ericjhoh/5-DOF-Arm/blog_documentation.docx

# Blog Documentation

## 8/20/2026

Due to all the backlash from the first version of the 30:1 Cycloidal Gearbox, I decided that there were likely 2 things to change that could reduce the given backlash.

1. 3D-print the cycloidal disks slightly larger than before.
2. Reprint the input wall so that the holes holding the roller pins were press-fit instead of loose fit.

I believed that the loose fit of the previous input wall roller pin holes allowed the pins to move slightly when the cycloidal disk applied pressure to the bearings. This means that when switching directions the cycloidal disk would have some give before the disk and the rollers latch back together.

## 8/21/2026

This day was spent printing most of the parts and testing whether they would fit. I found that printing the disk with an offset of .1 mm to increase the size worked the best with my 3d printer. The input wall holes for the roller should be the nominal 5 mm diameter.

## 8/22/2026

After assembly, I observed much less backlash than before and I will be testing the efficiency of the gearbox and compare it to version 1 of the 30:1 cycloidal gearbox. I will also be printing the 15:1 gearbox in the following days after adding identifiers in the CAD to make assembly easier.

## 8/23/2026

I spent this day printing most of the parts. I ran into some issues with the fitting of the shoulder bolts that secure the outer walls of the print, it was very tight for the 15:1.

## 8/24/2026

After assembling the entirety of the 15:1 gearbox, I noticed that the input shaft felt difficult to turn as if it were experiencing a lot of friction. From my observations it seemed like one of the input camshaft part was rubbing against the output flange making more friction.

## 8/25/2026

I didn’t get to work that much on the project this day, but I disassembled the 15:1

## 8/26/2026

After making some edits to the CAD, I am reprinting many parts so that they fit better together.

## 9/2/2026

I assembled the 15:1 gearbox and I loosened some of the shoulder bolts because if it was too tight the input hex shaft would be difficult to move.

## Updates

Tested all the custom cycloidal gearboxes

Bare motor - .2 NM input gave 3.0 N at .075 m away

15:1 - .2 Nm input gave 33.5 at .1 m away

15:1 - .1 NM input gave 15.5 N at .1 m away

30:1 - .1 Nm input gave 28.7 N at .1 m away

Cut hexshaft using a Dremel

May need to re-design the J1-J2 connector because it interferes with some of the interface of the J1 gearbox

Started full assembly of 5-DOF arm

Printed all parts. I had trouble printing the carbon fiber coupler because of the vertical hole where the M2.5 heated insert would be placed. The vertical hole had a very oblong shape. I tweaked the 3D-printer parameters and made the hole smaller in the CAD to allow for a more circular profile. Cut the carbon fiber tubes to length.

Making custom Y-splitter cables with solder in order to daisy chain power between the moteus r4.11 and the c1 controllers.

Extend the 8:1 gearbox phase wires from 16 AWG to 26 AWG with wire, solder, and heat shrink. Recrimp the encoder wires to the right profile of JST GH connectors for the C1

conf set aux1.spi.mode 1

conf set aux2.pins.0.mode 1

conf set aux2.pins.1.mode 1

conf set aux2.pins.2.mode 1

conf set aux2.pins.3.mode 2

conf set aux2.spi.mode 2

conf set aux2.spi.rate_hz 12000000

conf set motor_position.sources.0.aux_number 2

conf set motor_position.sources.0.type 1

conf set motor_position.sources.0.cpr 16384

conf set motor_position.sources.0.reference 0

conf set motor_position.commutation_source 0

conf set motor_position.output.source 0

conf set motor_position.rotor_to_output_ratio 0.125

conf write

## 9/13/26

We spent the entire time debugging CAN BUS communication. Our daisy chained crimped custom wires and solder jst-ph connectors did not seem to work as when we slightly pulled or pushed on the wires the CAN BUS communication did not work

We would run python -m moteus.moteus_tool -s to see if all our motor controllers would be read through the terminal this allowed us to check whether the CAN BUS communication could read all the motors.

After re-soldering the connectors and re-crimping the wires we determined to be faulty, we were able to consistently get the CAN communication fully through the whole arm.

## 9/14/26

We utilized an open source gripper+camera combo and made a custom connector to our J5 actuator. This allows for our robot to see.


9/15/26

Finishing up gripper assembly, and fully assembled robot, getting started on software development. We developed the framework of our robot controller with lerobot.

## 9/16-21/26

We developed the software by first tuning the PID of our motors and then setting joint limits. We first made teleoperation possible using a keyboard then an xbox controller. After practicing the pick-place task using the xbox controller, we recorded 30 observations of the pick-place task. Then using these parameters: ______ and an ACT policy to train the robotic arm, we were able to succeed at the pick-place task 90% of the time with 10 trials.
