ericjhoh/5-DOF-Arm/CAD/GearBoxes/Motor Housing/8_1 gearbox housings/jst-GH-7.png

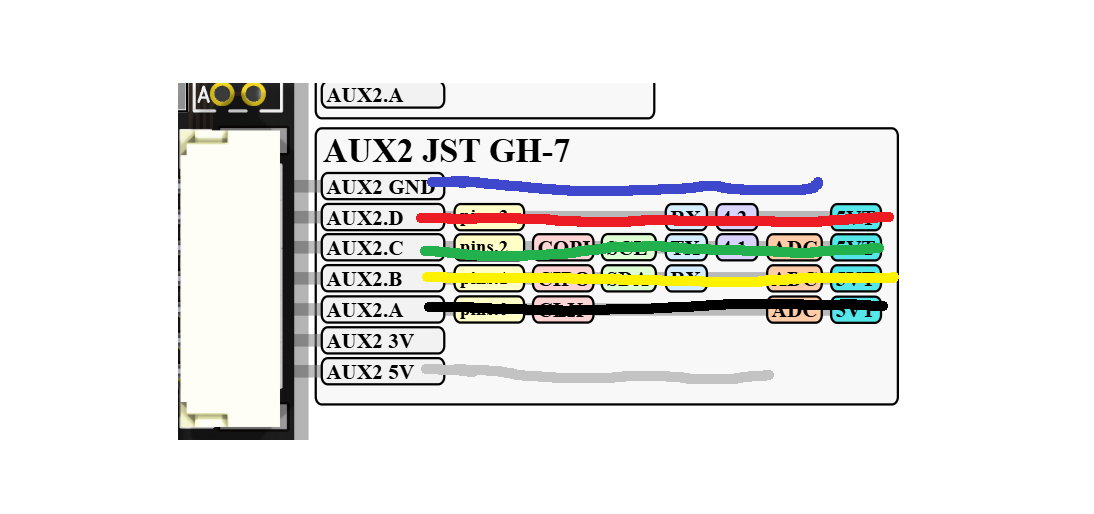
CAD/GearBoxes/Motor Housing/8_1 gearbox housings/jst-GH-7.png
