ericjhoh/5-DOF-Arm/5-DOF-Arm.xlsx

Sheet: Torque Budget
6-DoF Arm — Gravity Torque Budget v2 (elbow-mounted forearm roll)
Joint order (base to tool): J1 yaw·z, J2 shoulder pitch·x, J3 elbow pitch·x, J4 forearm roll·y AT ELBOW, J5 wrist roll·x. Blue cells = inputs. Worst case: arm horizontal.
GEOMETRY (total reach = shoulder pitch axis to tool center point)
L1 — upper arm (shoulder pitch to elbow pitch axis) | 0.250 | m
L2 — forearm (elbow pitch to wrist pitch axis) | 0.025 | m
L3 — wrist pitch axis to TCP | 0.125 | m |  |  |  |  |  | Payload CG assumed at TCP
d4 — J4 roll actuator CG offset distal of elbow | 0.030 | m |  |  |  |  |  | How far past the elbow pitch axis the J4 motor sits
Total reach | 0.400 | m |  |  |  |  |  | Target: 0.400 m as decided
MASSES
J3 elbow pitch actuator (mj5208 + r4.11 + cycloidal) | 0.890 | kg |  |  |  |  |  | Body mounted on upper-arm side of the joint
J4 forearm roll actuator (small motor + driver + housing) | 0.120 | kg |  |  |  |  |  | e.g. gimbal motor ~90 g + moteus-c1 ~9 g + printed reducer/housing
J5 Wrist (small motor + driver + housing) | 0.120 | kg |  |  |  |  |  | Was 0.35 kg with a 3-axis wrist — this is the payoff of the move
Gripper (actuator + jaws) | 0.150 | kg |  |  |  |  |  | Keep under ~0.2 kg
Payload (design requirement) | 0.200 | kg |  |  |  |  |  | 500 g spec
Upper arm link (CF tube + clamps, CG at L1/2) | 0.060 | kg
Forearm link (CF tube + clamps, CG at L1 + L2/2) | 0.060 | kg |  |  |  |  |  | Slightly heavier in practice: it must carry the J4 rotating interface
CONSTANTS & DESIGN FACTORS
Gravitational acceleration g | 9.81 | m/s²
Safety factor on continuous torque | 1.2 |  |  |  |  |  |  | Covers cycloidal friction variation, print quality, dynamic loads while carrying payload
ACTUATOR PARAMETERS
mj5208 continuous torque | 0.30 | Nm |  |  |  |  |  | Your figure, w/ heat spreader @ 24 V. Verify at thermal steady state on the bench.
mj5208 peak torque | 1.70 | Nm |  |  |  |  |  | mjbots spec; transient only
mj5208 speed at continuous rating | 240 | rpm |  |  |  |  |  | No-load speed is much higher; peak joint speed exceeds this
Cycloidal gearbox efficiency | 0.60 | - |  |  |  |  |  | ASSUMPTION — printed cycloidals range ~0.60–0.90. Measure and update.
Gear ratio — J1 base yaw | 15 | :1 |  |  |  |  |  | Gravity load ~0; existing 15:1 design is fine
Gear ratio — J2 shoulder pitch | 30 | :1 |  |  |  |  |  | 15:1 fails the budget below even with the lighter wrist
Gear ratio — J3 elbow pitch | 15 | :1 |  |  |  |  |  | Existing 15:1 design
Small motor continuous torque (J4–J6) | 0.20 | Nm |  |  |  |  |  | e.g. GM4108-class gimbal + moteus-c1. Edit if using a smart servo instead.
Small motor gear ratio (J4–J6) | 8 | :1 |  |  |  |  |  | Printed planetary; J4 wants a hollow bore or belt offset for wiring
Small motor gear efficiency | 0.85 | -
COMPONENT GRAVITY TORQUES — ARM HORIZONTAL (worst case)
Component | Mass (kg) |  | CG dist from shoulder (m) | CG dist from elbow (m) | τ about shoulder (Nm) | τ about elbow (Nm)
Upper arm link | 0.060 |  | 0.125 | — | 0.07 | 0.00
J3 elbow pitch actuator | 0.890 |  | 0.250 | — | 2.18 | 0.00
J4 forearm roll actuator (at elbow) | 0.120 |  | 0.280 | 0.030 | 0.33 | 0.04
Forearm link | 0.060 |  | 0.263 | 0.013 | 0.15 | 0.01
J5 Wrist | 0.120 |  | 0.275 | 0.025 | 0.32 | 0.03
Gripper | 0.150 |  | 0.338 | 0.087 | 0.50 | 0.13
Payload @ TCP | 0.200 |  | 0.400 | 0.150 | 0.78 | 0.29
TOTAL static gravity torque |  |  |  |  | 4.35 | 0.50
DISTAL AXIS GRAVITY TORQUES
Gripper about wrist pitch axis (CG at L3/2) |  |  |  |  | 0.09
Payload about wrist pitch axis (at L3) |  |  |  |  | 0.25
TOTAL — J5 wrist pitch requirement |  |  |  |  | 0.34 |  |  | J4 forearm roll sees the SAME worst case: with the wrist pitched 90°, the gripper + payload hang off the roll axis on the same lever arms
JOINT SIZING SUMMARY
Joint | Required cont. τ (Nm) | Req. × SF (Nm) | Ratio | Available cont. τ (Nm) | Margin (avail / req×SF) | Status | Peak τ avail (Nm) | Output speed (°/s)
J1 base yaw · z (mj5208) | 0.50 | 0.60 | 15 | 2.70 | 4.50 | PASS | 15.3 | 96
J2 shoulder pitch · x (mj5208) | 4.35 | 5.21 | 30 | 5.40 | 1.04 | PASS | 30.6 | 48
J3 elbow pitch · x (mj5208) | 0.50 | 0.59 | 15 | 2.70 | 4.54 | PASS | 15.3 | 96
J4 forearm roll · y (small motor) | 0.34 | 0.40 | 8 | 1.36 | 3.36 | PASS | —
J5 wrist pitch · x (small motor) | 0.34 | 0.40 | 8 | 1.36 | 3.36 | PASS | —
Notes:
• J1 required torque is an input: it carries ~zero gravity torque and is sized by friction + acceleration of full-arm inertia.
• J4 worst case = wrist pitched 90° with payload (same lever arms as J5), so both use the same requirement and actuator for commonality.
• vs the 3-axis-wrist version: shoulder requirement drops ~0.2 Nm and elbow ~0.15 Nm from moving one actuator's mass off the forearm tip.
• Route wiring for J5/gripper through or past J4: limit J4 travel (±~270°) with a cable service loop, or design a hollow-bore reducer.
• After the single-joint bench test, replace the 0.80 cycloidal efficiency assumption with the measured value.

Sheet: Timeline
Build Timeline — 6-DoF Arm for ML/RL Experiments (v2 architecture)
Assumes evenings/weekends pace alongside full-time work. Phases overlap deliberately — order long-lead parts early. Durations are estimates; the exit criterion is what matters.
# | Phase | Weeks | Key tasks & exit criteria | Notes | Recommendations
1 | Finalize budget & architecture | 1–2 | Fill this workbook with real masses; lock reach (400 mm), z-x-x-y-x-y joint layout, J2 ratio, J4–J6 actuator choice. Exit: every joint row reads PASS. | J4 and J5 share a requirement (~0.45 Nm) — use the identical actuator + reducer for both, and ideally J6 too, for spare-parts commonality. | Order long-lead parts NOW: mj5208s, r4.11s, heat spreaders, CAN-FD USB adapter, CF tube, bearings, small motors + moteus-c1s. Shipping is your critical path.
2 | Single-joint bench test (mj5208 + 15:1 cycloidal) | 2–3 | Rig one joint with a weighted lever. Measure: continuous torque at thermal steady state (20+ min hold, log winding temp via moteus telemetry), gearbox efficiency, backlash, friction. Exit: measured values entered into the Torque Budget sheet. | Validates the two biggest assumptions (0.3 Nm continuous, 0.80 efficiency). Printed cycloidal efficiency varies 0.60–0.90 with print quality and grease. | Log via moteus telemetry — the same friction/backlash data becomes your sim parameters later. Compare PETG vs PLA cycloidal discs for wear while you're at it.
3 | J4 roll joint + wrist prototype | 3–5 | Build the J4 forearm roll joint first — it's the novel one: small motor + moteus-c1 + hollow-bore (or belt-offset) reducer, with the distal wiring harness passing through. Then the 2-axis wrist. Exit: J4 holds 0.45 Nm with wiring routed and ±270° travel limits set; wrist cluster weighed at ≤ budget. | The rotating wire pass-through is the highest-risk detail of this architecture. Prove it before committing to the forearm design. Set voltage_mode_control if gimbal current-sense torque is noisy. | Give the harness a generous helical service loop through the J4 bore and enforce soft travel limits in moteus config. If J4 drags on, fall back to a smart-servo wrist and add the roll later.
4 | Full arm CAD | 4–7 | Model complete arm incl. the J4 rotating interface, wiring routes, controller mounting, service loops. Pull mass properties into the Torque Budget sheet and iterate. Exit: budget still PASS with CAD masses + 10% contingency. | Split-clamp CF tube fittings (bolted, not glued) let you change link lengths after testing. Bearings, not printed bores, on all moment-loaded interfaces — especially the J4 output, which sees the full forearm bending moment. | Design so J4, J5, J6 axes intersect at one wrist-center point — that preserves closed-form IK (Pieper's condition). Add joint hard-stops so a runaway policy can't self-collide at full torque.
5 | Electronics & power integration | 6–8 | 24 V PSU (~10–15 A), power distribution, daisy-chained CAN-FD through all 6 controllers + gripper, termination, physical e-stop cutting motor power. Exit: all nodes enumerate; 100 Hz command/telemetry loop stable from Jetson or PC. | One mjcanfd-usb-1x handles the whole chain — r4.11 and c1 share the same bus, firmware, and API. Keep Jetson logic power separate from motor power. | Add a bus voltage monitor: regen from decelerating joints pumps the rail up. Configure moteus flux braking before the first fast motion.
6 | Fabrication & assembly | 7–9 | Print structure (PETG for structural/heat-adjacent parts), cut tubes, assemble, torque-check fasteners. Exit: arm holds a static pose under closed-loop control without thermal throttling. | Expect 2–3 reprints of joint housings; that's normal. Anneal or thicken parts near motor heat spreaders. | Assemble and test joint-by-joint from the base up — much easier to isolate mechanical vs firmware issues.
7 | Calibration & controller tuning | 8–10 | Per-joint encoder calibration, direction/limit config, position + velocity + torque tuning, gravity compensation feedforward from this sheet's mass model. Exit: arm tracks smooth trajectories with 500 g payload, no overheating over a 15-min cycle. | Gravity comp is nearly free — the mass/CG model is already in the Torque Budget sheet. It dramatically improves teleop feel and cuts steady-state heating. | Add output-side AS5047 encoders (r4.11 aux SPI) on J2/J3 if cycloidal backlash exceeds ~0.5° — joint-side truth matters for RL state.
8 | Software: driver + LeRobot integration | 9–11 | Python moteus driver wrapped in a LeRobot robot class; camera integration; teleop (leader arm, spacemouse, or keyboard). Exit: record a LeRobot dataset end-to-end with synced camera + joint states. | You've already debugged the hard parts on the YAM arm — record-loop FPS, camera sync, and rerun latency lessons transfer directly. | Run policy/teleop at 30–50 Hz; let moteus onboard loops handle high-rate control. Keep camera reads asynchronous from the record loop from day one this time.
9 | Sim model & system ID | 10–12 | Build URDF/MJCF from CAD; import to MuJoCo (and Isaac Lab for GPU sim); fit joint friction, damping, backlash from Phase 2/7 logs. Exit: sim joint step responses match hardware within ~10–15%. | Printed cycloidal friction is the dominant sim-to-real gap — it's load-dependent, so fit at several torque levels. Note the wrist singularity at J5 = 0 (J4 and J6 axes align) — joint-space policies don't care, Cartesian teleop will. | Export CAD with simplified collision meshes now; retrofitting them later is painful. Randomize friction/backlash in training rather than chasing a perfect fit.
10 | First learning experiments | 12+ | Baseline tasks: reach, pick-place, peg-in-hole. Start with imitation learning (ACT/diffusion policy on teleop demos), then RL fine-tuning in sim. | Train on the gaming PC (RAM/GPU matter for training); Jetson for deployment/inference only. | Start with IL from ~50 teleop demos before any RL — it validates the whole platform with far less debugging surface than sim-to-real RL.

Sheet: BOM
# | BOM Level | Item | Qty | Price per Unit | Specifications | link | Ordered On | # of Packs Ordered | Shipping/Tax | Total Cost
1 | 1 | 6-DoF Robotic Arm | 1 |  | 6-DOF Robotic Arm |  |  |  |  | $1390.51
1.1 | 2 | Proximal joint actuation — J1–J3 (mj5208 + printed cycloidal) |  |  |  |  |  |  |  | $960.84
1.1.1 | 3 | mj5208 brushless motor | 2 | $74.00 | Drives J1 & J2 | Here (https://mjbots.com/products/mj5208?variant=37262679900321) | 2026-08-03 | 2/2 | $2.44 | $148.00
1.1.2 | 3 | moteus r4.11 controller | 2 | $94.00 | J1 & J2 | Here (https://mjbots.com/products/moteus-r4-11?variant=41896124154017) | 2026-08-03 | 2/2 | $2.44 | $188.00
1.1.3 | 3 | moteus r4.11 developer kit | 1 | $219.00 | J3 motor + controller bundle | Here (https://mjbots.com/products/moteus-r4-11-developer-kit) | 2026-07-10 | 1/1 | $2.44 | $219.00
1.1.4 | 3 | moteus r4 heat spreader | 3 | $29.00 | One per mj5208 joint (J1–J3) | Here (https://mjbots.com/products/moteus-heat-spreader?variant=37322050437281) | 7/10/2026 8/3/2026 | 1/3 2/3 | $11.07 | $87.00
1.1.5 | 3 | SteadyWin GIM3505-8 planetary reducer motor | 2 | $65.00 | J4, J5, J6 (V1.0 with encoder) | Here (https://aifitlab.com/products/steadywin-gim3505-8-planetary-reducer-servo-motor?variant=44388211785864) | 2026-07-10 | 3/3 | $30.00 | $130.00
1.1.6 | 3 | moteus-c1 controller | 2 | $69.00 | J4, J5, J6 | Here (https://aifitlab.com/products/steadywin-gim3505-8-planetary-reducer-servo-motor?variant=44388211785864) | 2026-08-03 | 3/3 | $2.44 | $138.00
1.2 | 2 | Cycloidal gearbox — 30:1 (J2 shoulder) | 1 | Price/Pack |  |  |  |  |  | $135.48
1.2.1 | 3 | Roller Pin | 39 | $7.21 | Ø5mm x 30mm (50 pcs) | Here (https://www.amazon.com/Juvielich-Stainless-Cylindrical-Bookshelf-Furniture/dp/B0DKBMBQ9K?s=industrial) | 2026-07-27 | 1 | $7.68 | $7.21
1.2.2 | 3 | Roller/Output Bearings | 78 | $12.99 | ID 5mm x OD 10mm x 4mm (30 pcs) | Here (https://www.amazon.com/Mlxkell-MR105-2RS-Bearings-5x10x4mm-Double/dp/B0B18W8TYH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) | 2026-07-27 | 3 |  | $38.97
1.2.3 | 3 | Camshaft Bearings | 4 | $9.99 | ID 15mm x OD 28mm x 7mm (8 pcs) | Here (https://www.amazon.com/uxcell-6902-2RS-Bearing-1180902-Bearings/dp/B07FWC3SJD?s=industrial) | 2026-07-27 | 1 |  | $9.99
1.2.4 | 3 | Input/Output Flanged Bearings | 2 | $9.79 | ID 50mm x OD 65mm x 7mm (2 pcs) | Here (https://www.amazon.com/uxcell-6810-2RS-Groove-Bearings-Double/dp/B082PXZLJT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) | 2026-07-27 | 1 |  | $9.79
1.2.5 | 3 | M5 Heat Set Threaded Inserts | 17 | $6.99 | M5 x Ø10mm x 7mm (50 pcs) | Here (https://www.amazon.com/FFVRVSS-Threaded-Assortment-Printing-Components/dp/B0H1V72B3B?th=1) | 2026-07-27 | 1 |  | $6.99
1.2.6 | 3 | M2.5 Heat Set Threaded Inserts | 5 | $8.99 | M2.5 x Ø3.5mm x 4mm (100 pcs) | Here (https://www.amazon.com/Hanglife-HANGLIFE-Heat-Set-Threaded-Inserts/dp/B0CS6YVJYD?th=1) | 2026-07-27 | 1 |  | $8.99
1.2.7 | 3 | Shoulder bolts M5 | 8 | $7.79 | M5x0.8 around 64mm in total length (4 pcs) | Here (https://www.amazon.com/MECCANIXITY-Stainless-Hydraulic-Injection-Industries/dp/B0FDQWSQZJ) | 2026-07-27 | 2 |  | $15.58
1.2.8 | 3 | M5 Screw | 9 | $22.99 | M5x0.8 x 13mm length | Here | 2026-07-27 | 1 |  | $22.99
1.2.9 | 3 | M3 Screw | 7 |  | M3 x 4mm length (4) 6mm length (3)
1.2.10 | 3 | M2.5 Screw | 4 |  | M2.5 x 4mm length |  | Already Have
1.2.11 | 3 | M2.5 Set Screw | 1 | $7.29 | M2.5 x 4mm length (50 pieces) | Here (https://www.amazon.com/gp/product/B0GW45XBP2/ref=ox_sc_act_title_1?smid=A2C1Q80HIP80AY&th=1) | 2026-07-27 | 1 |  | $7.29
1.2.12 | 3 | Hex Shaft | 1 | $21.45 | 5mm x 51mm (4 pcs 400mm in length each) | Here (https://www.amazon.com/Hexagonal-Wearproof-Intelligent-Robots-Equipment/dp/B09NHQFZZG) | Already Have
1.2.13 | 3 | 30-Ouput Flange | 1 |  | 3D Printed Parts
1.2.14 | 3 | 30-Input Flange | 1
1.2.15 | 3 | 30-Thin Spacer | 78
1.2.16 | 3 | 30-Thick Spacer | 39
1.2.17 | 3 | 30-Cycloidal Disk | 2
1.2.18 | 3 | 30-Eccentric Cam | 2
1.2.19 | 3 | 30-Centered Cam | 1
1.2.20 | 3 | 30-Input Cam | 1
1.2.21 | 3 | 30-Motor Housing | 1
1.2.22 | 3 | 30-Mid Wall | 1
1.2.23 | 3 | 30-Output Wall | 1
1.2.24 | 3 | 30-Output Wall | 1
1.2.25 | 3 | 30-Coupler | 1
1.3 | 2 | Cycloidal gearbox — 15:1 (J1, J3) | 2 | Price/Pack |  |  |  |  |  | $103.49
1.3.1 | 3 | Roller Pin | 22 | $7.21 | Ø5mm x 30mm (50 pcs) | Here (https://www.amazon.com/Juvielich-Stainless-Cylindrical-Bookshelf-Furniture/dp/B0DKBMBQ9K?s=industrial) | 2026-08-03 | 1 | $5.87 | $7.21
1.3.2 | 3 | Roller/Output Bearings | 44 | $12.99 | ID 5mm x OD 10mm x 4mm (30 pcs) Purchase 3 packs for two 15:1 gearboxes | Here (https://www.amazon.com/Mlxkell-MR105-2RS-Bearings-5x10x4mm-Double/dp/B0B18W8TYH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) | 2026-08-03 | 3 |  | $38.97
1.3.3 | 3 | Camshaft Bearings | 4 | $8.09 | ID 10mm x OD 15mm x 4mm (10 pcs) Purchase 1 pack for two 15:1 gearboxes | Here (https://www.amazon.com/uxcell-6700ZZ-Groove-Bearings-Shielded/dp/B082PPYZQX) | 2026-08-03 | 1 |  | $8.09
1.3.4 | 3 | Input/Output Flanged Bearings | 2 | $9.99 | ID 40mm x OD 52mm x 7mm (4 pcs) Purchase 1 pack for two 15:1 gearboxes | Here (http://amazon.com/HARFINGTON-6808-2RS-Bearings-Bearing-Conveyors/dp/B0CGM46PYL?adgrpid=186430327876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) | 2026-08-03 | 1 |  | $9.99
1.3.5 | 3 | M5 Heat Set Threaded Inserts | 15 | $6.99 | M5 x Ø10mm x 7mm (50 pcs) | Here (https://www.amazon.com/FFVRVSS-Threaded-Assortment-Printing-Components/dp/B0H1V72B3B?th=1) | Already have from 30:1 |  |  | $0.00
1.3.6 | 3 | M2.5 Heat Set Threaded Inserts | 5 | $8.99 | M2.5 x Ø3.5mm x 4mm (100 pcs) | Here (https://www.amazon.com/Hanglife-HANGLIFE-Heat-Set-Threaded-Inserts/dp/B0CS6YVJYD?th=1) | Already have from 30:1 |  |  | $0.00
1.3.7 | 3 | Shoulder bolts M5 | 6 | $7.79 | M5x0.8 around 54mm in total length (4 pcs) Purchase 3 packs for two 15:1 gearboxes | Here (https://www.amazon.com/MECCANIXITY-Stainless-Hydraulic-Injection-Industries/dp/B0FDQW5GKG) | 2026-08-03 | 3 |  | $23.37
1.3.8 | 3 | M5 Screw | 9 | $22.99 | M5x0.8 x 10mm length | Here | Already have from 30:1 |  |  | $0.00
1.3.9 | 3 | M3 Screw | 7 |  | M3 x 4mm length (4) 6mm length (3)
1.3.10 | 3 | M2.5 Screw | 4 | $9.99 | M2.5 x 4mm length | Here (https://www.amazon.com/Fgruh-M2-5-Assortment-Stainless-Assorted/dp/B0FG2BYJSR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) | 2026-08-03 | 1 |  | $9.99
1.3.11 | 3 | M2.5 Set Screw | 1 | $7.29 | M2.5 x 4mm length (50 pieces) | Here (https://www.amazon.com/gp/product/B0GW45XBP2/ref=ox_sc_act_title_1?smid=A2C1Q80HIP80AY&th=1) | Already Have from 30:1 |  |  | $0.00
1.3.12 | 3 | Hex Shaft | 1 | $21.45 | 5mm x 56mm (4 pcs 400mm in length each) | Here (https://www.amazon.com/Hexagonal-Wearproof-Intelligent-Robots-Equipment/dp/B09NHQFZZG) | Already Have
1.3.13 | 3 | 15-Ouput Flange | 1 |  | 3D Printed Parts Need to 2x prints for two 15:1 gearboxes
1.3.14 | 3 | 15-Input Flange | 1
1.3.15 | 3 | 15-Thin Spacer | 44
1.3.16 | 3 | 15-Thick Spacer | 22
1.3.17 | 3 | 15-Cycloidal Disk | 2
1.3.18 | 3 | 15-Eccentric Cam | 2
1.3.19 | 3 | 15-Centered Cam | 1
1.3.20 | 3 | 15-Input Cam | 1
1.3.21 | 3 | 15-Motor Housing | 1
1.3.22 | 3 | 15-Mid Wall | 1
1.3.23 | 3 | 15-Output Wall | 1
1.3.24 | 3 | 15-Output Wall | 1
1.3.25 | 3 | 15-Coupler | 1
1.3.25 | 3 | 15-camshaft_spacer | 3
1.4 | 3 | Misc |  | Price/Pack |  |  |  |  |  | $190.70
1.3.1 | 4 | 16 AWG Silicone Wire Red Black | 1 | $7.21 | 10ft Stranded Tinned Copper Wire | Here (https://www.amazon.com/gp/product/B017TFR664/ref=ox_sc_act_title_3?smid=AITZO53LNBA1K&th=1) | 2026-08-03 | 1 | $5.87 | $7.21
1.3.2 | 4 | 2pcs Carbon Fiber Tube | 1 | $24.33 | 25mmx23mmx420mm 3K roll Wrapped Twill Matte Finish | Here (https://www.amazon.com/dp/B07V6TRBB1?ref=ppx_yo2ov_dt_b_fed_asin_title) | 2026-09-06 | 1 |  | $24.33
1.3.3 | 4 | GH1.25 Connectors and Crimp Terminal kit | 1 | $10.99 | Compatible with JST GH Connectors Plugs 1.25mm Pitch | Here (https://www.amazon.com/dp/B07V6TRBB1?ref=ppx_yo2ov_dt_b_fed_asin_title) | 2026-09-08 | 1 |  | $10.99
1.3.4 | 4 | Camera for gripper | 1 | $31.99 | Arducam 5MP Wide Angle USB Camera for Computer, 1/4" CMOS OV5648 Mini UVC USB2.0 Video Webcam with Microphone, with 3.3ft/1m Cable | Here (https://www.amazon.com/dp/B0972KK7BC?ref=ppx_yo2ov_dt_b_fed_asin_title&th=1) | 2026-09-08 | 1 |  | $31.99
1.3.5 | 4 | Power supply Y-splitter cables | 1 | $9.99 | Frienda 20 Pairs XT30 Connectors Male Female, Gold Plated RC Lipo Battery | Here (https://www.amazon.com/dp/B0875MBLNH?ref=ppx_yo2ov_dt_b_fed_asin_title) | 2026-09-08 | 1 |  | $9.99
1.3.6 | 4 | Servo controller for gripper | 1 | $12.99 | Waveshare Serial Bus Servo Driver Board, Integrates Servo Power Supply and Control Circuit, Applicable for ST/SC Series Serial Bus Servos, Small in Size, Easy to Integrate | Here (https://www.amazon.com/dp/B0CJ6TP3TP?ref=ppx_yo2ov_dt_b_fed_asin_title) | 2026-09-08 | 1 |  | $12.99
1.3.7 | 4 | Servo Wiring | 1 | $9.59 | (6PCS) 5264-3PIN Servo Cable (6PCS), for ST/SC/CF Servos, 900MM / 90CM Length | Here (https://www.amazon.com/dp/B0GZV9MQ6L?ref=ppx_yo2ov_dt_b_fed_asin_title) | 2026-09-10 | 1 |  | $9.59
1.3.8 | 4 | Servo | 1 | $30.90 | waveshare 30KG High Precision and Torque Servo Motor Metal Gear ST3215 Programmable 360° Magnetic Encoder Serial Bus Servo for Robot Project,Two-Way Feedback, Servo/Motor Mode Switchable | Here (https://www.amazon.com/dp/B0B6P9271Q?ref=ppx_yo2ov_dt_b_fed_asin_title) | 2026-09-10 | 1 |  | $30.90
1.3.9 | 4 | Servo Set Screws | 1 | $5.29 | M3 x 4mm 304 Stainless Steel | Here (https://www.amazon.com/dp/B0DNXPSV5T?ref=ppx_yo2ov_dt_b_fed_asin_title&th=1) | 2026-09-12 | 1 |  | $5.29
1.3.10 | 4 | Servo Flanged Bearings | 1 | $8.58 | 6x10x3mm Miniature Flanged Bearings, | Here (https://www.amazon.com/dp/B0DT9LC6G5?ref=ppx_yo2ov_dt_b_fed_asin_title&th=1) | 2026-09-12 | 1 |  | $8.58
1.3.11 | 4 | M2 screw set | 1 | $9.99 | 1600Pcs M2 Screws,M2*4/6/8/10/12/16/20/25mm Screw kit | Here (https://www.amazon.com/dp/B0G7H56GTN?ref=ppx_yo2ov_dt_b_fed_asin_title) | 2026-09-13 | 1 |  | $9.99
1.3.12 | 4 | Carbon fiber tube | 1 | $9.99 | Carbon Fiber Round Tube 6mm x 4mm x 200mm | Here (https://www.amazon.com/dp/B0951XVCLP?ref=ppx_yo2ov_dt_b_fed_asin_title&th=1) | 2026-09-14 | 1 |  | $9.99
1.3.13 | 4 | Adjustable Voltage Regulator | 1 | $12.99 | Servo power supply | Here (https://www.amazon.com/dp/B07KWX33X5?ref=ppx_yo2ov_dt_b_fed_asin_title&th=1) |  | 1 |  | $12.99
