ericjhoh/5-DOF-Arm/CAD/5-DOF Arm/Actuators+Linkages/j4j5_assem/j4j5_assem.SLDASM

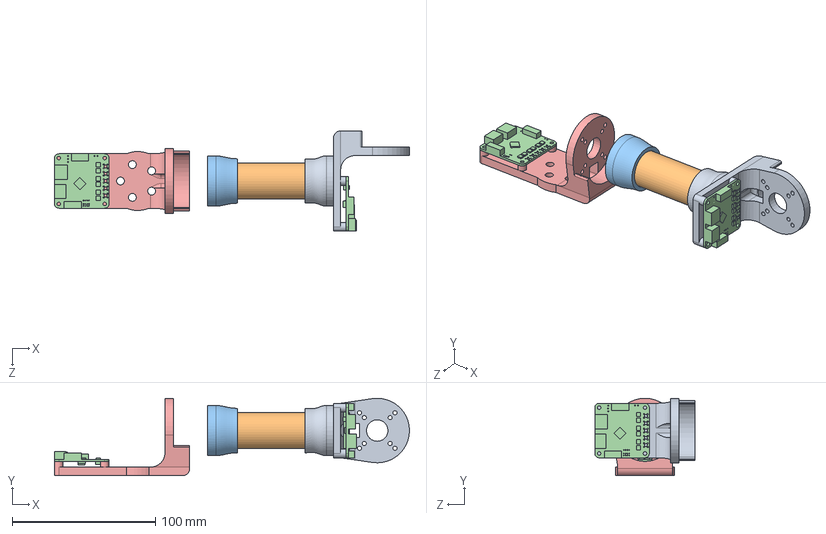
[picture p10: CAD file, 2026-09-25]
CAD/5-DOF Arm/Actuators+Linkages/j4j5_assem/j4j5_assem.SLDASM
247.5 x 54.0 x 70.0 mm
j4_connector
moteus_c1 x 2
j5_connector_1
carbon_fiber_tube
j5_connector_2
