ericjhoh/5-DOF-Arm/CAD/5-DOF Arm/gripper+camera+linkage/models/parts/RB9.01.062.010 Main frame.STL

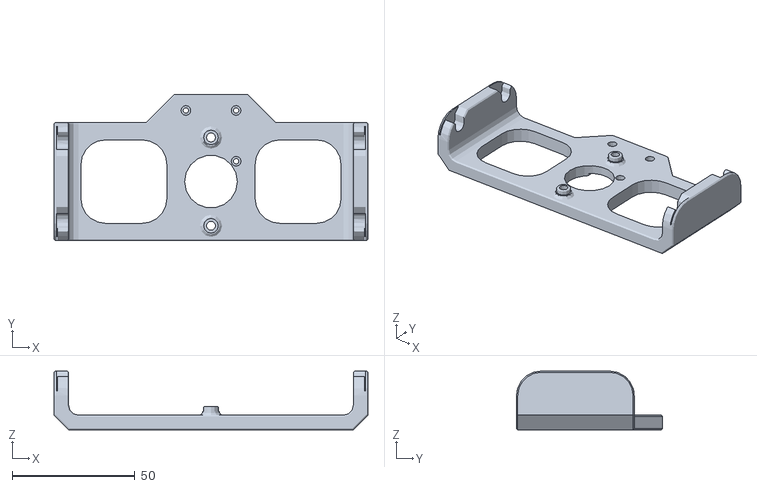
[picture p11: CAD file, 2026-09-18]
CAD/5-DOF Arm/gripper+camera+linkage/models/parts/RB9.01.062.010 Main frame.STL
128.0 x 59.5 x 24.0
