ericjhoh/5-DOF-Arm/CAD/5-DOF Arm/Actuators+Linkages/j4j5_assem/15-output_flange.SLDPRT

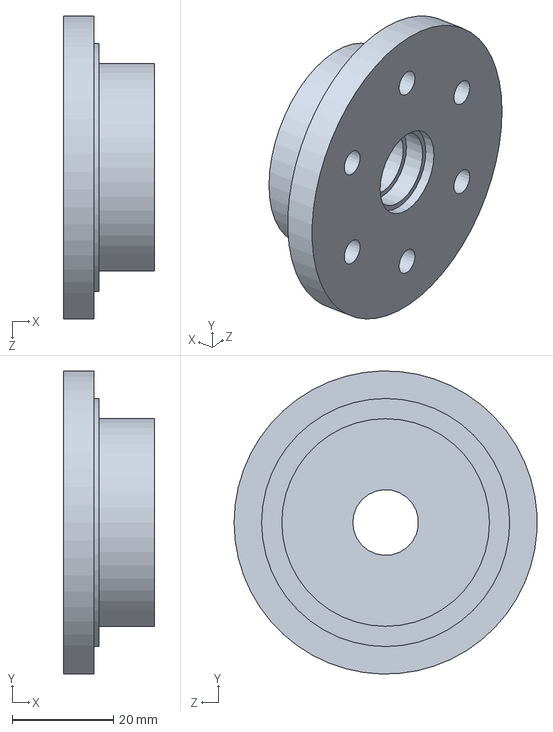
[picture p12: CAD file, 2026-09-25]
CAD/5-DOF Arm/Actuators+Linkages/j4j5_assem/15-output_flange.SLDPRT
18.0 x 60.0 x 59.9 mm
