ericjhoh/5-DOF-Arm/CAD/5-DOF Arm/gripper+camera+linkage/connector.SLDPRT

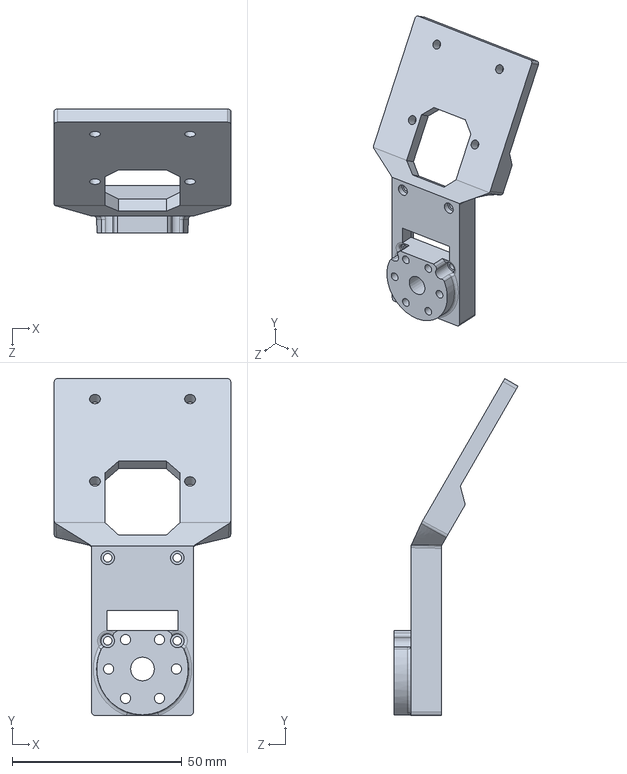
[picture p13: CAD file, 2026-09-18]
CAD/5-DOF Arm/gripper+camera+linkage/connector.SLDPRT
52.0 x 99.3 x 36.5 mm
