ericjhoh/5-DOF-Arm/CAD/5-DOF Arm/gripper+camera+linkage/models/parts/gear_2024.SLDPRT

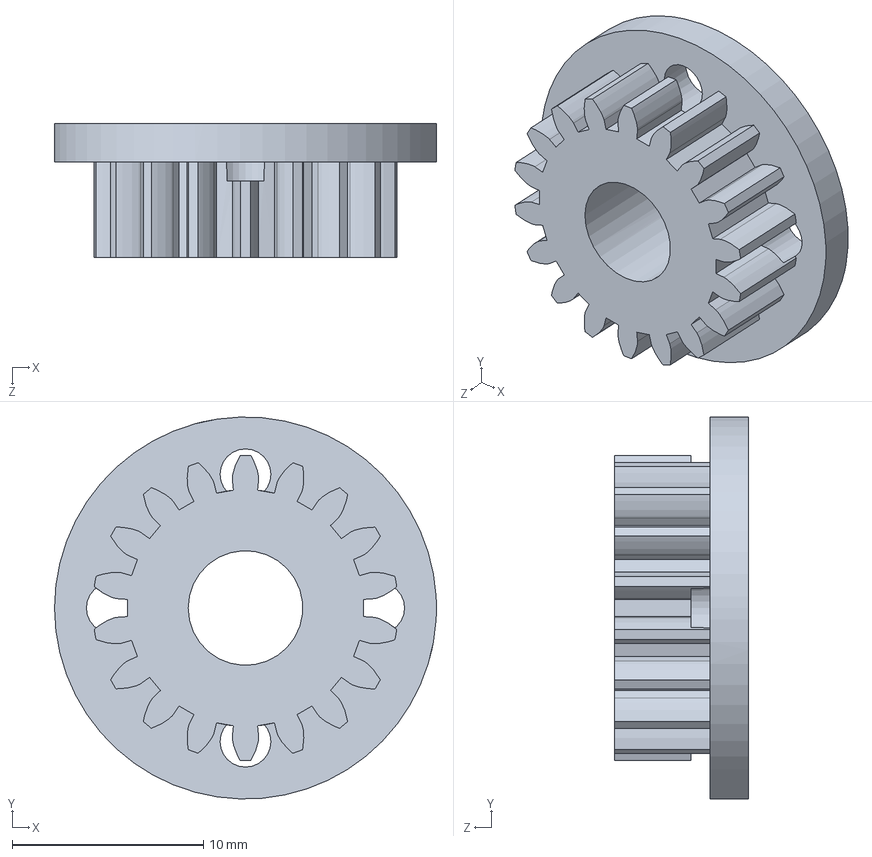
[picture p14: CAD file, 2026-09-23]
CAD/5-DOF Arm/gripper+camera+linkage/models/parts/gear_2024.SLDPRT
20.0 x 20.0 x 7.00 mm
