ericjhoh/5-DOF-Arm/CAD/5-DOF Arm/gripper+camera+linkage/models/RB9.01.062.000 Gripper.STEP

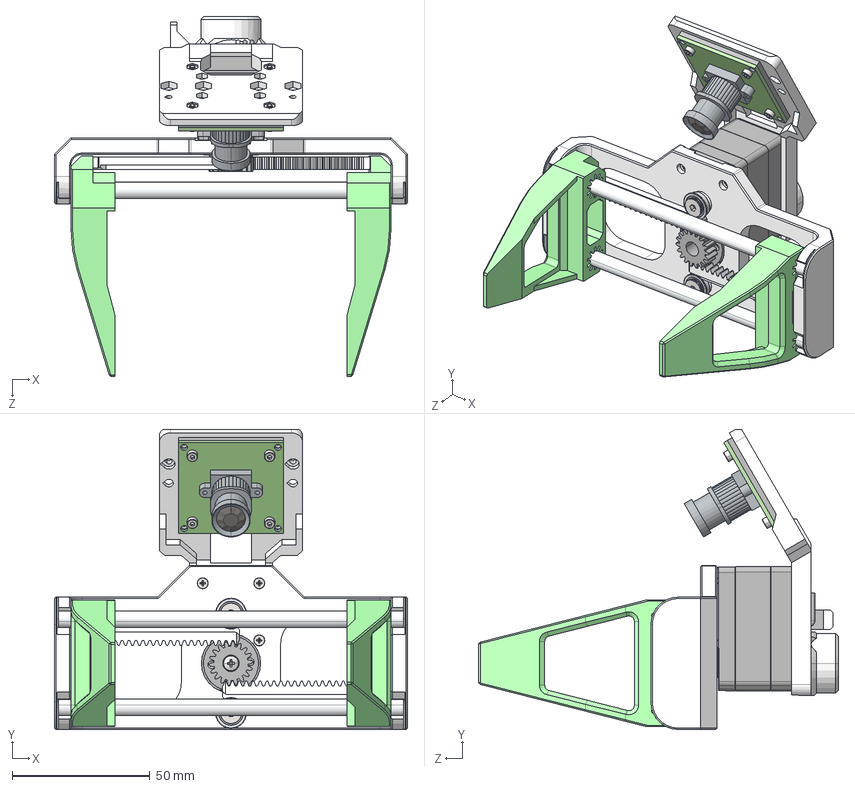
[picture p15: CAD file, 2026-09-18]
CAD/5-DOF Arm/gripper+camera+linkage/models/RB9.01.062.000 Gripper.STEP
128.0 x 108.8 x 130.5 mm
RB9.01.062.010 Main frame_125 follower
RB9.01.062.020 Clamp x 2
RB9.01.062.030 Gear rack_m0.8 x 2
RB9.01.062.040 Gear for gripper_ISO - Spur gear 0.8M 18T 20PA 5FW ---S18B10H8L6.0S1
RB9.01.062.070 Camera holder_follower + camera
RB9.01.060.090 Camera spacer
Rod d6_125 x 2
ZK_122^STS3215_Servo
SG-ZIJI_15^STS3215_Servo
XG-ZIJI_16^STS3215_Servo
Main Wheel^STS3215_Servo
pan head cross recess screw_din_DIN EN ISO 7045 - M3 x 4 - Z - 4N
0050375033_｢ｯ燿｢ｮ
GC2093 2MP USB Camera Module_IMX335 5MP USB Camera
Bearing_MF106 10å6å3 x 2
countersunk flat head cross recess screw_din_DIN EN ISO 7046-1 - M2 x 8 - Z - 8N x 3
socket countersunk head screw_din_DIN 7991 - M4 x 8 --- 8N x 2
hex nut style 1 gradeab_din_Hexagon Nut ISO 4032 - M2 - D - N x 4
socket head cap screw_din_DIN 912 M2 x 8 --- 8N x 4
