ericjhoh/5-DOF-Arm/CAD/5-DOF Arm/stls/j4j5 - j5_connector_2-1.STL

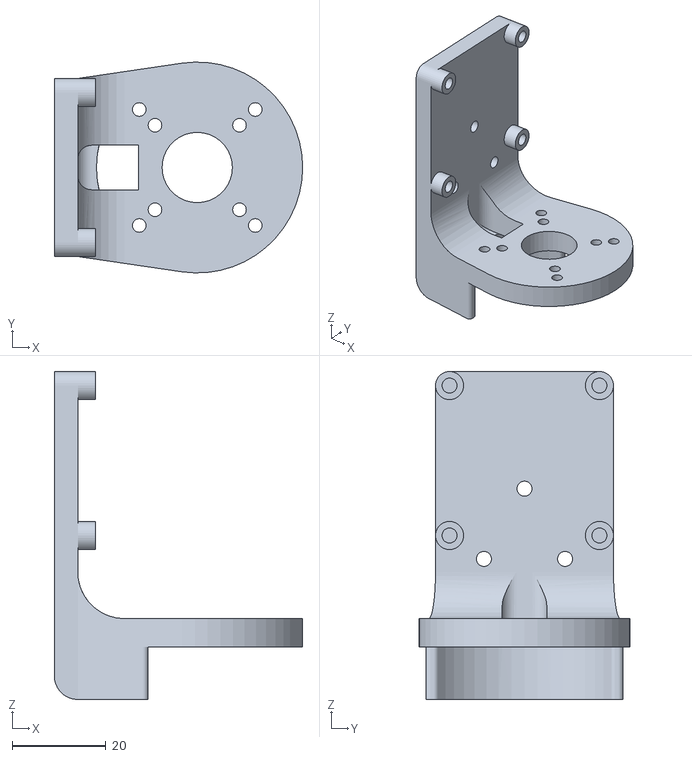
[picture p16: CAD file, 2026-09-18]
CAD/5-DOF Arm/stls/j4j5 - j5_connector_2-1.STL
53.0 x 45.0 x 70.0
