ericjhoh/5-DOF-Arm/CAD/5-DOF Arm/URDF/5-DOF_Arm_ASY_URDF/meshes/base_link.STL

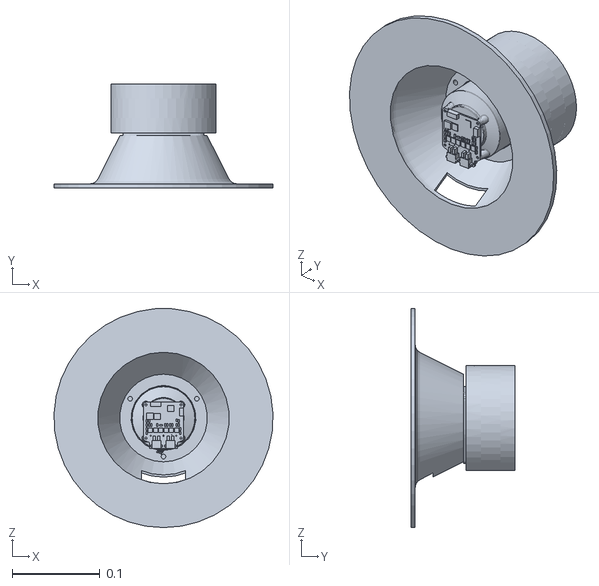
[picture p17: CAD file, 2026-11-08]
CAD/5-DOF Arm/URDF/5-DOF_Arm_ASY_URDF/meshes/base_link.STL
0.25 x 0.119 x 0.25
