ericjhoh/5-DOF-Arm/CAD/GearBoxes/15-1 Cycloidal Gearbox/Gearbox/15-middle_wall.SLDPRT

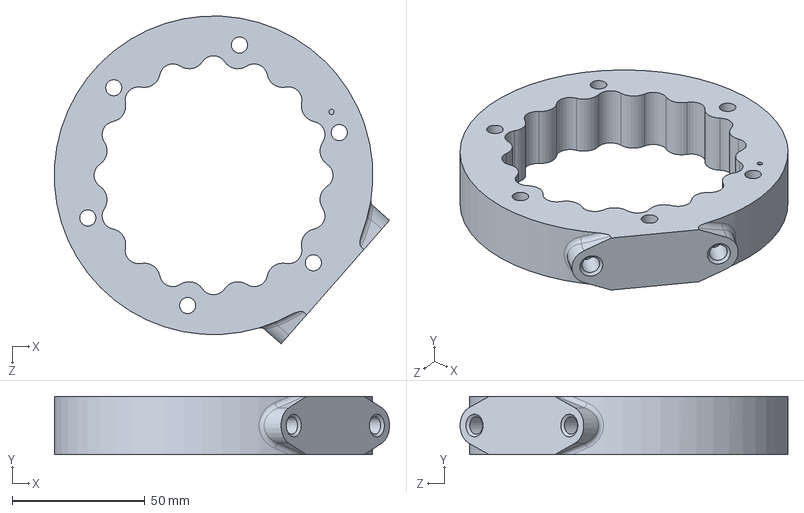
[picture p18: CAD file, 2026-11-13]
CAD/GearBoxes/15-1 Cycloidal Gearbox/Gearbox/15-middle_wall.SLDPRT
126.2 x 22.0 x 123.4 mm
