ericjhoh/5-DOF-Arm/CAD/GearBoxes/15-1 Cycloidal Gearbox/Gearbox/Attachments/15-J1-output.SLDPRT

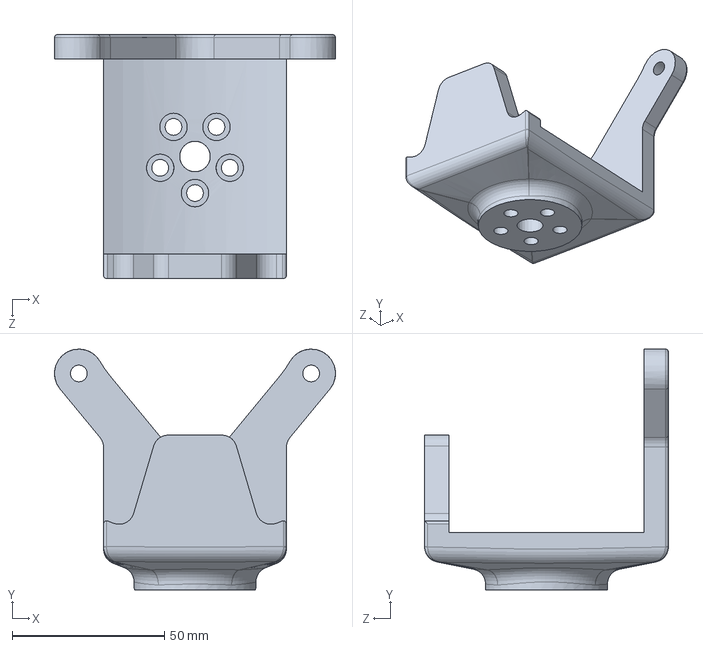
[picture p19: CAD file, 2026-09-18]
CAD/GearBoxes/15-1 Cycloidal Gearbox/Gearbox/Attachments/15-J1-output.SLDPRT
92.2 x 79.0 x 80.0 mm
