ericjhoh/5-DOF-Arm/CAD/GearBoxes/30-1 Cycloidal Gearbox/Gearbox/Attachments/30_attachement2.SLDPRT

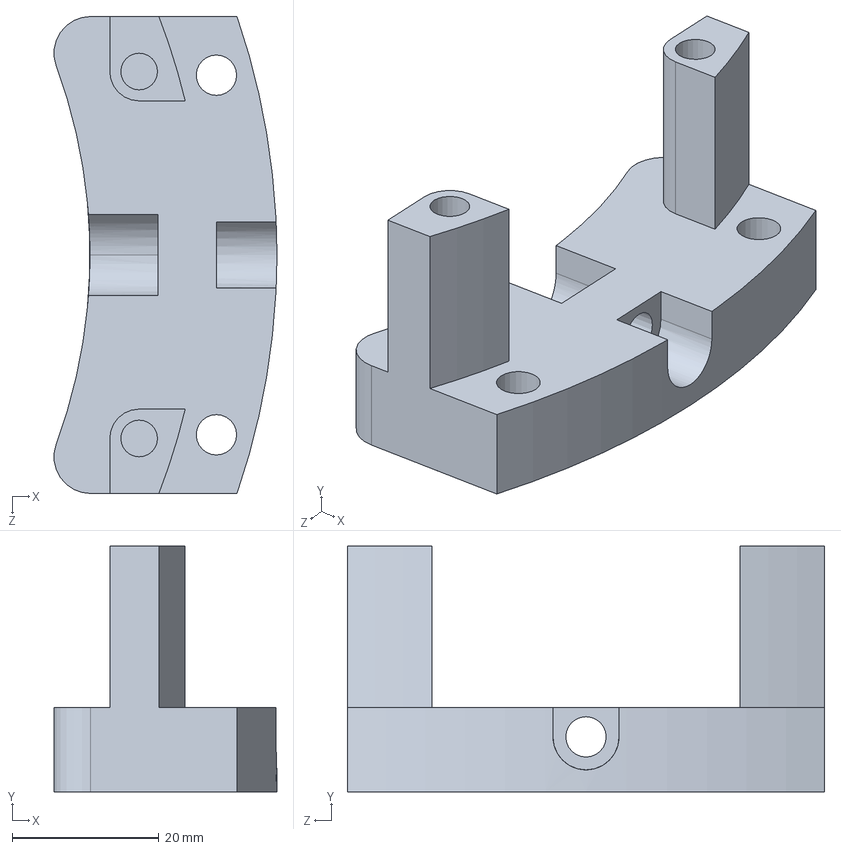
[picture p20: CAD file, 2026-11-13]
CAD/GearBoxes/30-1 Cycloidal Gearbox/Gearbox/Attachments/30_attachement2.SLDPRT
30.3 x 33.5 x 65.0 mm
