ericjhoh/5-DOF-Arm/CAD/5-DOF Arm/carbon_fiber_tube.SLDPRT

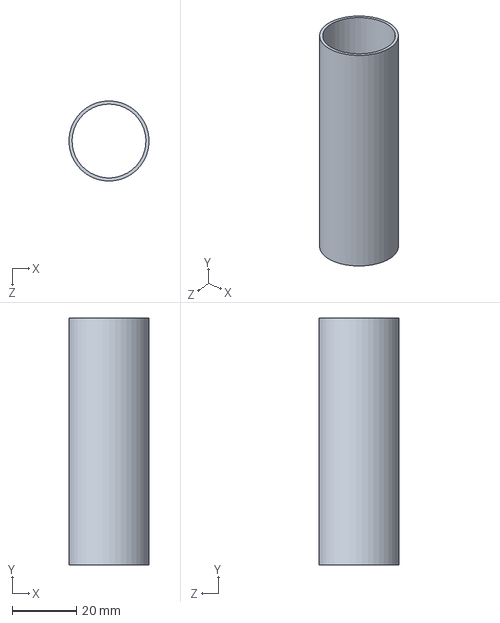
[picture p21: CAD file, 2026-09-25]
CAD/5-DOF Arm/carbon_fiber_tube.SLDPRT
24.9 x 77.0 x 25.0 mm
