ericjhoh/5-DOF-Arm/CAD/5-DOF Arm/gripper+camera+linkage/models/Follower gripper (165x165 bed size).STL

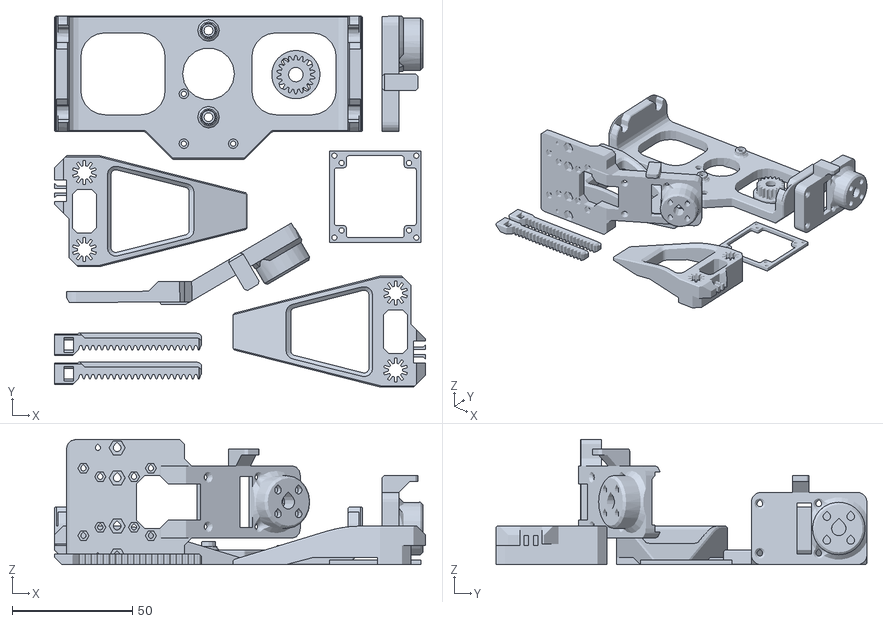
[picture p22: CAD file, 2026-09-18]
CAD/5-DOF Arm/gripper+camera+linkage/models/Follower gripper (165x165 bed size).STL
154.1 x 154.0 x 52.0
