ericjhoh/5-DOF-Arm/CAD/5-DOF Arm/stls/j4j5 - j4_connector-1.3mf

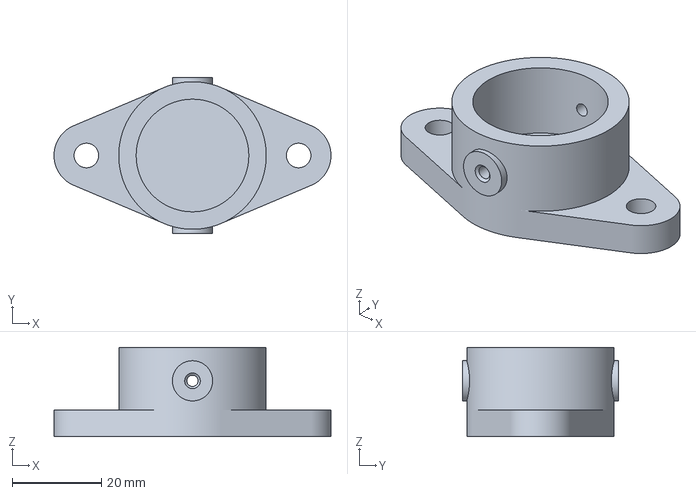
[picture p23: CAD file, 2026-09-18]
CAD/5-DOF Arm/stls/j4j5 - j4_connector-1.3mf
62.0 x 35.0 x 20.0 mm
