ericjhoh/5-DOF-Arm/CAD/5-DOF Arm/URDF/5-DOF_Arm_ASY_URDF/meshes/end_effector.STL

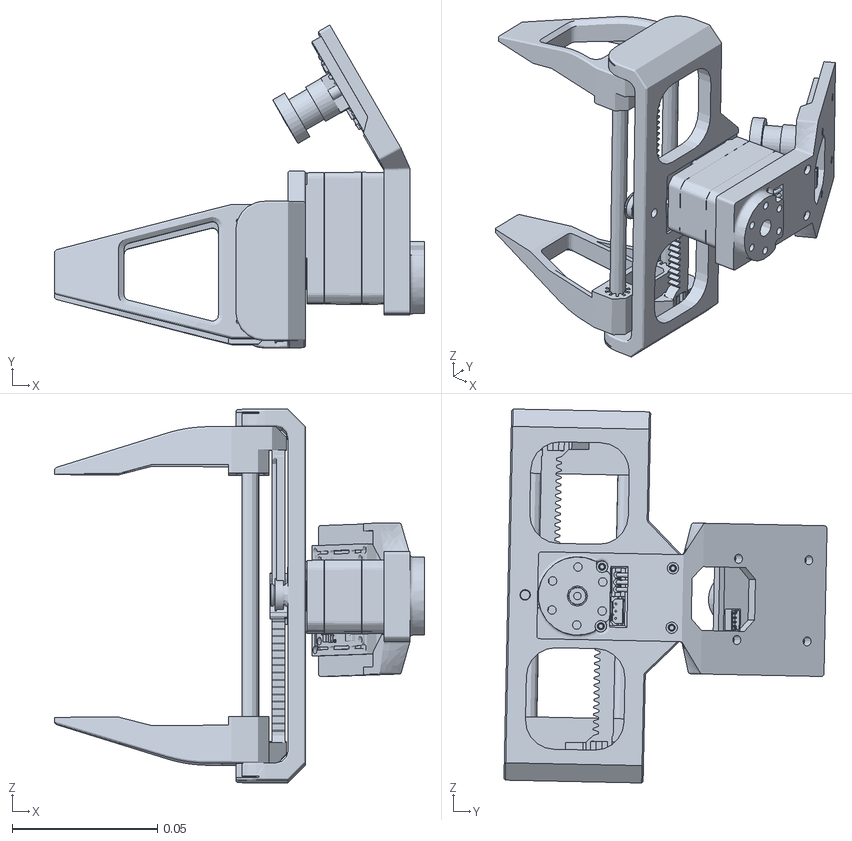
[picture p24: CAD file, 2026-11-08]
CAD/5-DOF Arm/URDF/5-DOF_Arm_ASY_URDF/meshes/end_effector.STL
0.128 x 0.111 x 0.129
