ericjhoh/5-DOF-Arm/CAD/GearBoxes/15-1 Cycloidal Gearbox/Gearbox/Stls/15-input_wall.STL

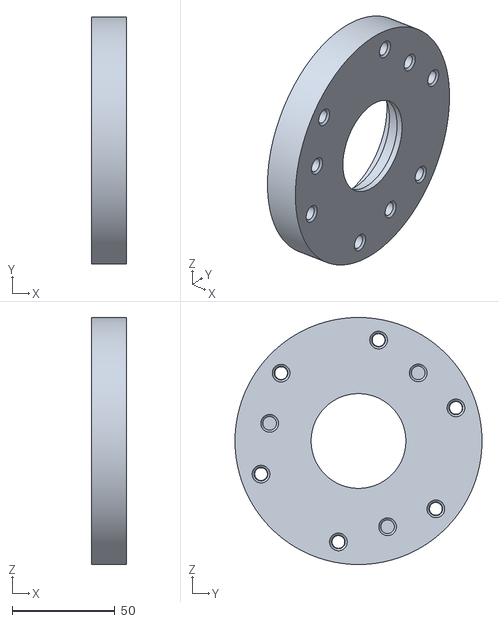
[picture p25: CAD file, 2026-09-07]
CAD/GearBoxes/15-1 Cycloidal Gearbox/Gearbox/Stls/15-input_wall.STL
17.0 x 120.0 x 120.0
