ericjhoh/5-DOF-Arm/CAD/GearBoxes/Motor Housing/motor housing.SLDPRT

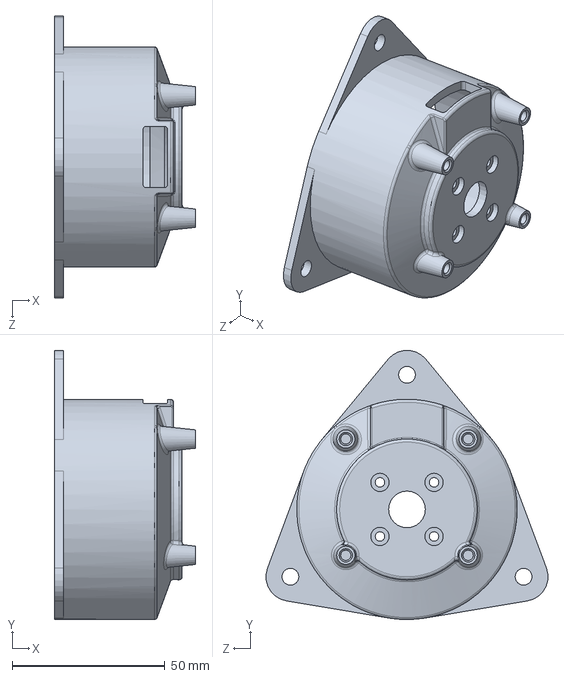
[picture p28: CAD file, 2026-09-07]
CAD/GearBoxes/Motor Housing/motor housing.SLDPRT
46.2 x 87.9 x 92.1 mm
