ericjhoh/5-DOF-Arm/CAD/5-DOF Arm/Actuators+Linkages/j4j5_assem/moteus_c1.SLDPRT

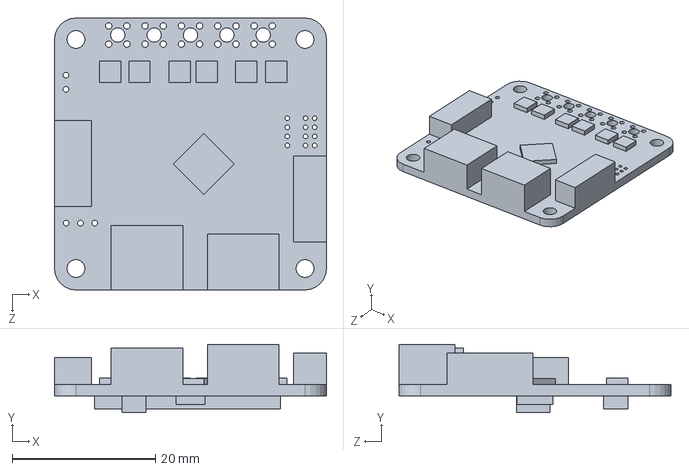
[picture p29: CAD file, 2026-09-25]
CAD/5-DOF Arm/Actuators+Linkages/j4j5_assem/moteus_c1.SLDPRT
38.0 x 9.50 x 38.0 mm
