ericjhoh/5-DOF-Arm/CAD/5-DOF Arm/gripper+camera+linkage/models/parts/RB9.01.062.031 Gear rack.STL

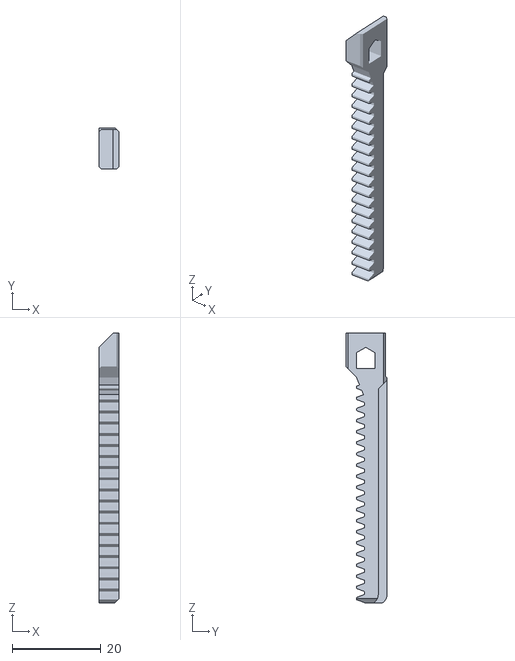
[picture p30: CAD file, 2026-09-18]
CAD/5-DOF Arm/gripper+camera+linkage/models/parts/RB9.01.062.031 Gear rack.STL
4.50 x 9.35 x 61.0
