ericjhoh/5-DOF-Arm/CAD/5-DOF Arm/stls/j4j5 - j5_connector_1-1.STL

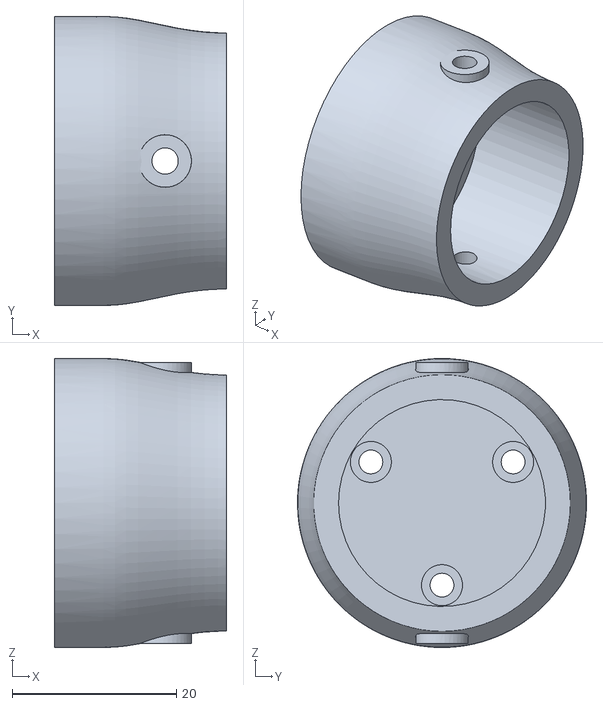
[picture p31: CAD file, 2026-09-18]
CAD/5-DOF Arm/stls/j4j5 - j5_connector_1-1.STL
21.0 x 35.2 x 35.2
