ericjhoh/5-DOF-Arm/CAD/5-DOF Arm/URDF/5-DOF_Arm_ASY_URDF/meshes/shoulder_link.STL

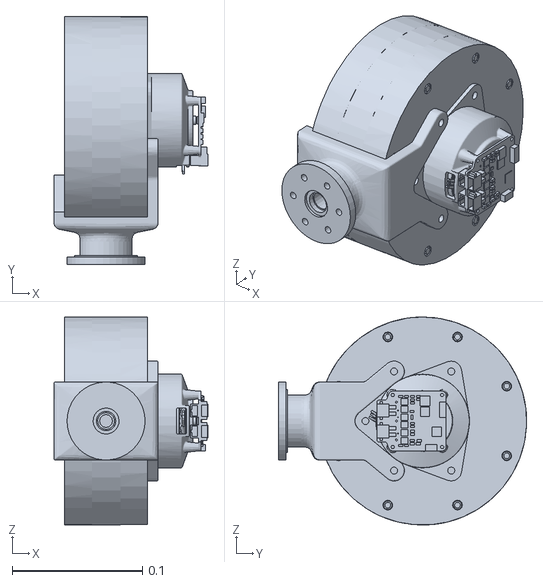
[picture p32: CAD file, 2026-11-08]
CAD/5-DOF Arm/URDF/5-DOF_Arm_ASY_URDF/meshes/shoulder_link.STL
0.118 x 0.191 x 0.16
