ericjhoh/5-DOF-Arm/CAD/GearBoxes/15-1 Cycloidal Gearbox/Gearbox/Stls/15-middle_wall_print_j1.STL

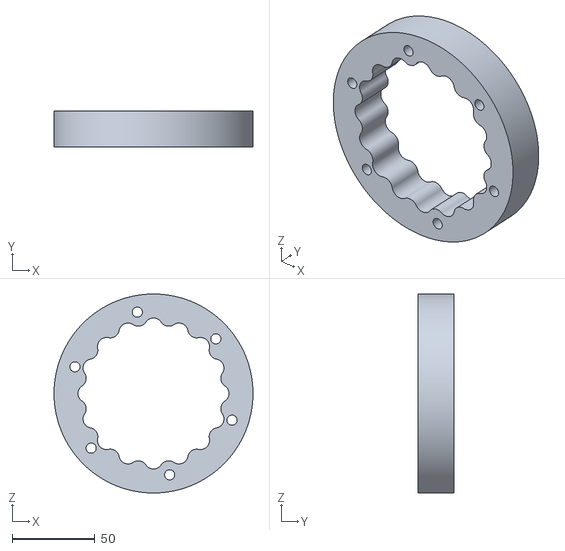
[picture p34: CAD file, 2026-09-07]
CAD/GearBoxes/15-1 Cycloidal Gearbox/Gearbox/Stls/15-middle_wall_print_j1.STL
120.0 x 22.0 x 120.0
