ericjhoh/5-DOF-Arm/CAD/GearBoxes/Motor Housing/coupler_print.SLDPRT

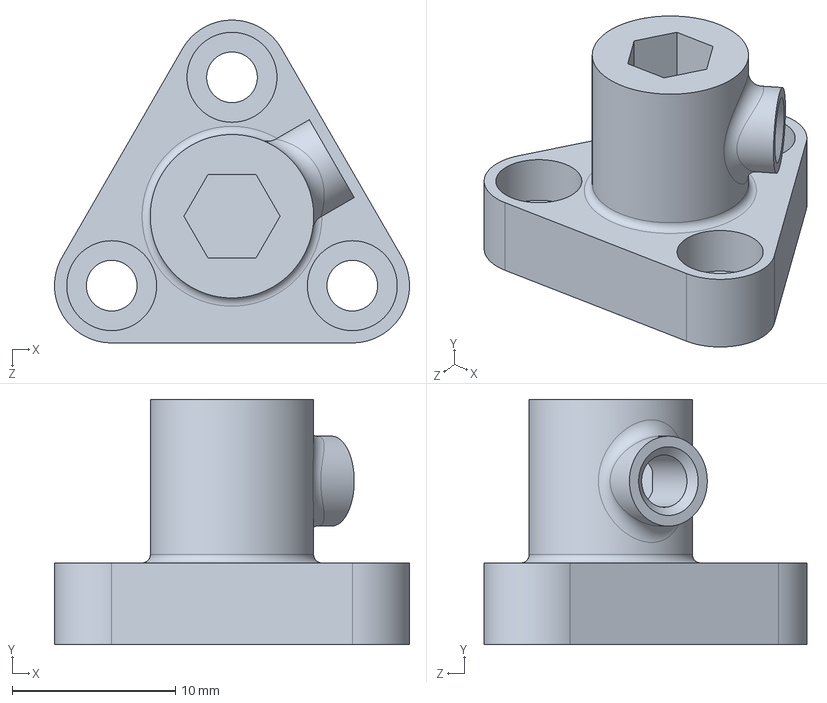
[picture p35: CAD file, 2026-09-07]
CAD/GearBoxes/Motor Housing/coupler_print.SLDPRT
21.7 x 15.0 x 19.8 mm
