ericjhoh/5-DOF-Arm/CAD/5-DOF Arm/Actuators+Linkages/j4j5_assem/j5_connector_1.SLDPRT

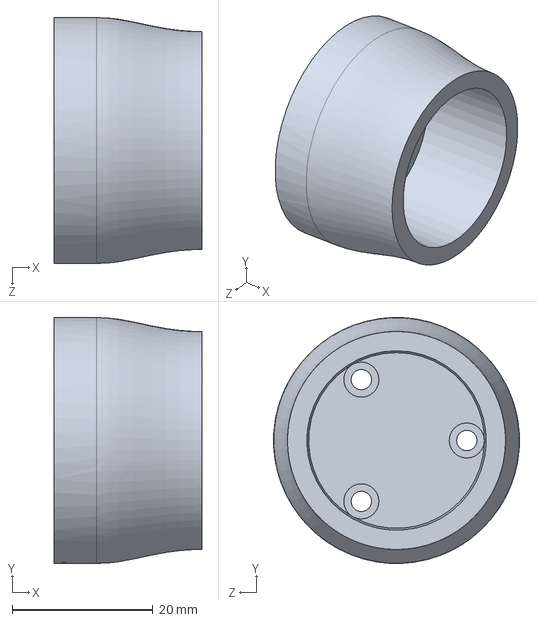
[picture p36: CAD file, 2026-09-25]
CAD/5-DOF Arm/Actuators+Linkages/j4j5_assem/j5_connector_1.SLDPRT
21.0 x 35.0 x 35.0 mm
