ericjhoh/5-DOF-Arm/CAD/5-DOF Arm/base_support.SLDPRT

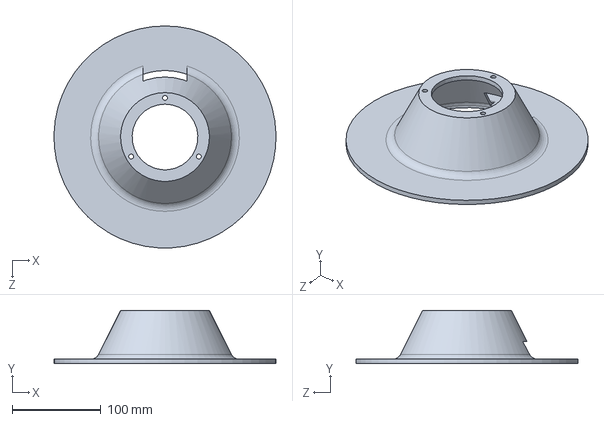
[picture p37: CAD file, 2026-09-18]
CAD/5-DOF Arm/base_support.SLDPRT
249.9 x 60.0 x 250.0 mm
