ericjhoh/5-DOF-Arm/CAD/5-DOF Arm/URDF/5-DOF_Arm_ASY_URDF/meshes/forearm_link.STL

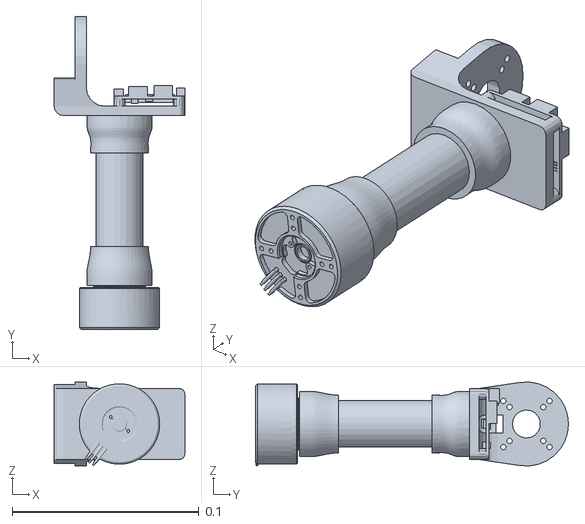
[picture p39: CAD file, 2026-11-08]
CAD/5-DOF Arm/URDF/5-DOF_Arm_ASY_URDF/meshes/forearm_link.STL
0.07 x 0.168 x 0.0449
