ericjhoh/5-DOF-Arm/CAD/GearBoxes/30-1 Cycloidal Gearbox/Gearbox/30-cycloidal_disk.SLDPRT

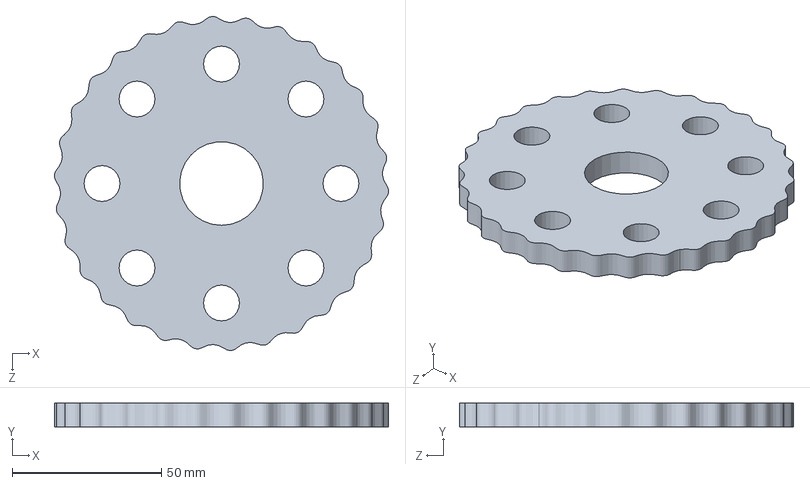
[picture p40: CAD file, 2026-11-13]
CAD/GearBoxes/30-1 Cycloidal Gearbox/Gearbox/30-cycloidal_disk.SLDPRT
111.9 x 8.00 x 111.8 mm
