ericjhoh/5-DOF-Arm/CAD/5-DOF Arm/Actuators+Linkages/j4j5_assem/j4_connector.SLDPRT

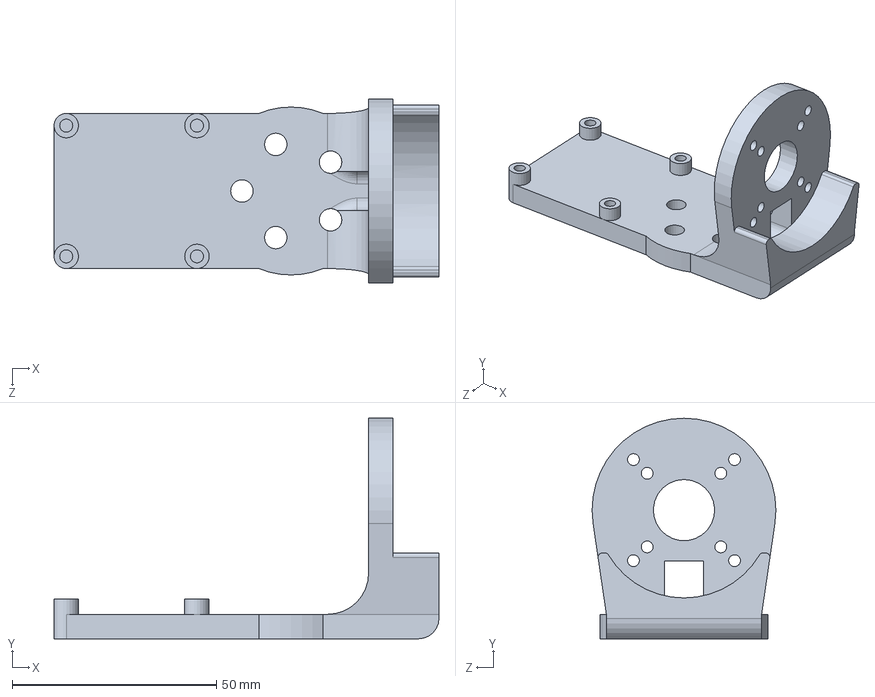
[picture p41: CAD file, 2026-09-20]
CAD/5-DOF Arm/Actuators+Linkages/j4j5_assem/j4_connector.SLDPRT
94.2 x 54.0 x 45.0 mm
