ericjhoh/5-DOF-Arm/CAD/5-DOF Arm/gripper+camera+linkage/D435_Solid.SLDPRT

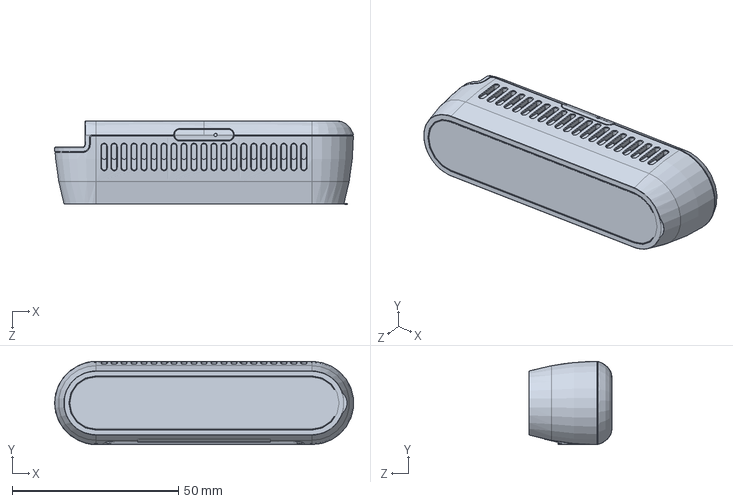
[picture p42: CAD file, 2026-09-18]
CAD/5-DOF Arm/gripper+camera+linkage/D435_Solid.SLDPRT
89.8 x 25.0 x 25.1 mm
