ericjhoh/5-DOF-Arm/CAD/5-DOF Arm/gripper+camera+linkage/models/parts/RB9.01.062.040 Gear.SLDPRT

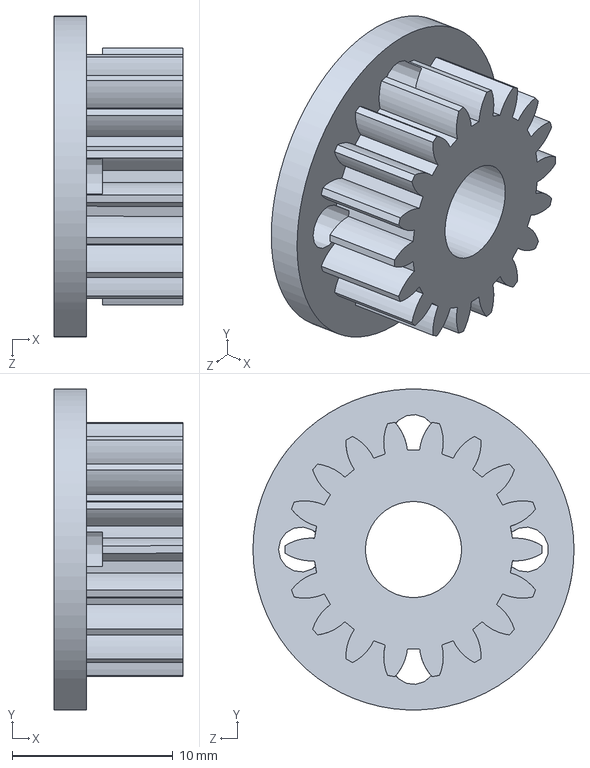
[picture p43: CAD file, 2026-09-18]
CAD/5-DOF Arm/gripper+camera+linkage/models/parts/RB9.01.062.040 Gear.SLDPRT
8.00 x 20.0 x 20.0 mm
