ericjhoh/5-DOF-Arm/CAD/5-DOF Arm/URDF/5-DOF_Arm_ASY_URDF/meshes/elbow_link.STL

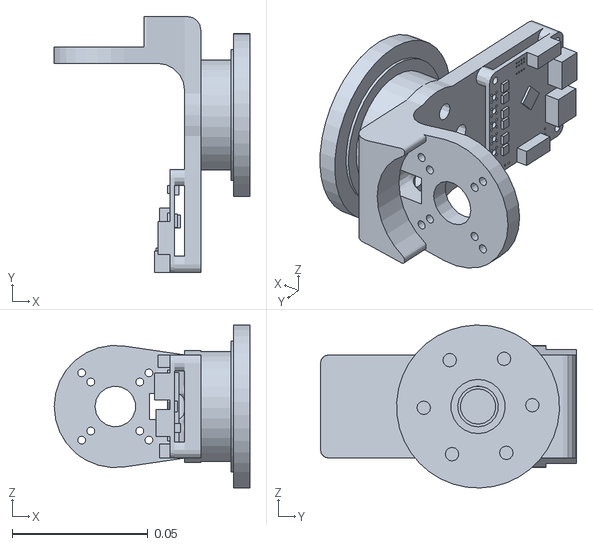
[picture p44: CAD file, 2026-11-08]
CAD/5-DOF Arm/URDF/5-DOF_Arm_ASY_URDF/meshes/elbow_link.STL
0.072 x 0.0942 x 0.06
