ericjhoh/5-DOF-Arm/CAD/5-DOF Arm/Actuators+Linkages/j4j5_assem/carbon_fiber_tube_j4j5.SLDPRT

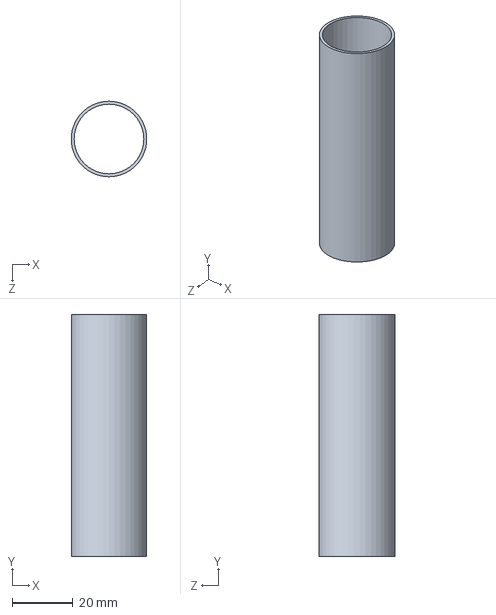
[picture p45: CAD file, 2026-09-20]
CAD/5-DOF Arm/Actuators+Linkages/j4j5_assem/carbon_fiber_tube_j4j5.SLDPRT
24.9 x 80.0 x 25.0 mm
