ericjhoh/5-DOF-Arm/CAD/5-DOF Arm/gripper+camera+linkage/models/parts/RB9.01.060.090 Camera spacer.3mf

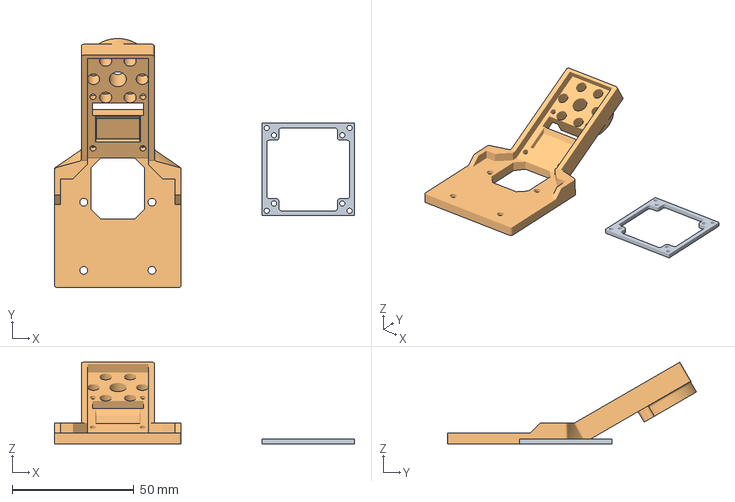
[picture p46: CAD file, 2026-09-18]
CAD/5-DOF Arm/gripper+camera+linkage/models/parts/RB9.01.060.090 Camera spacer.3mf
123.1 x 102.1 x 33.5 mm
RB9.01.060.090 Camera spacer.STL
connector.STL
