ericjhoh/5-DOF-Arm/CAD/GearBoxes/30-1 Cycloidal Gearbox/Gearbox/30-output_wall.SLDPRT

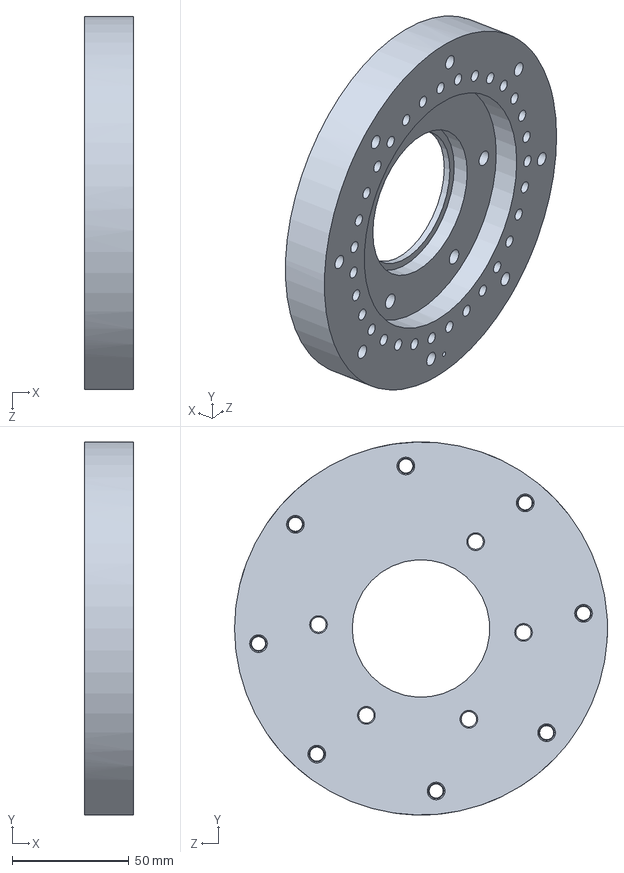
[picture p48: CAD file, 2026-11-13]
CAD/GearBoxes/30-1 Cycloidal Gearbox/Gearbox/30-output_wall.SLDPRT
21.0 x 159.9 x 160.0 mm
