ericjhoh/5-DOF-Arm/CAD/5-DOF Arm/Actuators+Linkages/j4j5_assem/j5_connector_2.SLDPRT

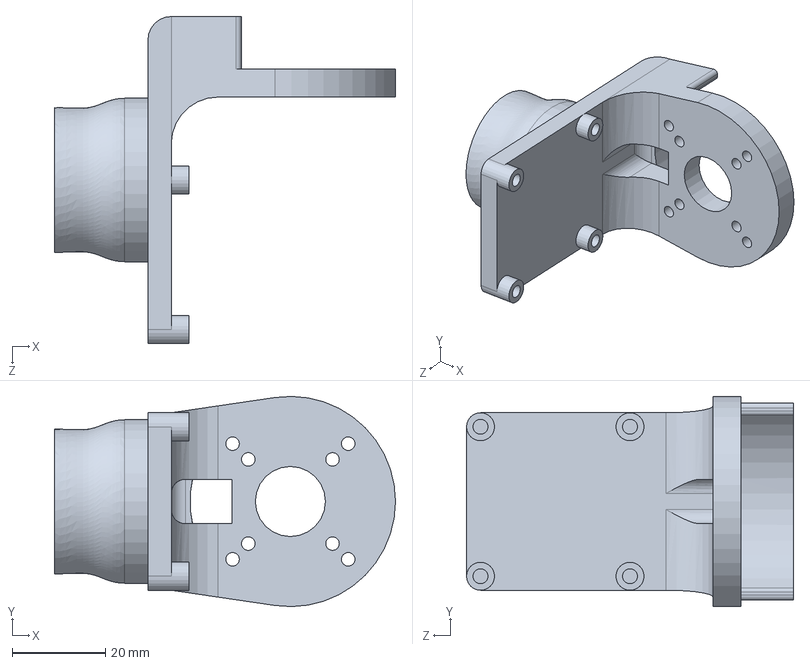
[picture p49: CAD file, 2026-09-20]
CAD/5-DOF Arm/Actuators+Linkages/j4j5_assem/j5_connector_2.SLDPRT
73.0 x 45.0 x 70.0 mm
