ericjhoh/5-DOF-Arm/CAD/5-DOF Arm/gripper+camera+linkage/models/parts/RB9.01.062.020 Clamp.STL

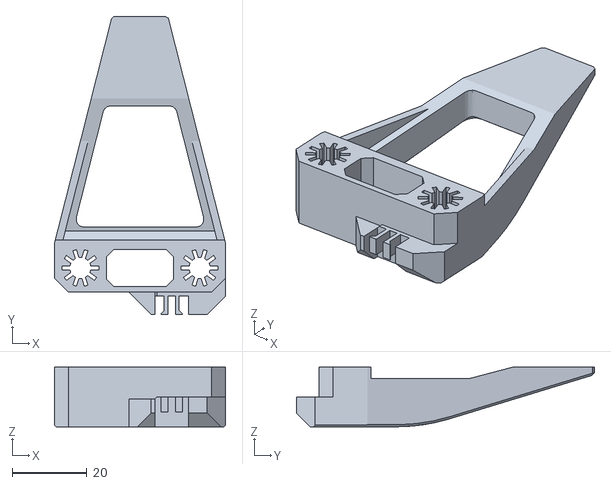
[picture p50: CAD file, 2026-09-18]
CAD/5-DOF Arm/gripper+camera+linkage/models/parts/RB9.01.062.020 Clamp.STL
46.0 x 80.0 x 16.0
