ericjhoh/5-DOF-Arm/CAD/GearBoxes/15-1 Cycloidal Gearbox/Gearbox/15-camshaft_part.SLDPRT

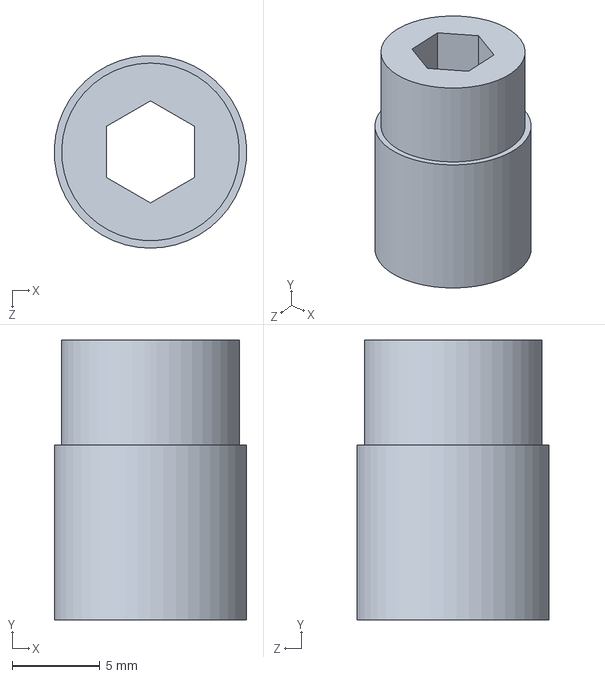
[picture p52: CAD file, 2026-11-08]
CAD/GearBoxes/15-1 Cycloidal Gearbox/Gearbox/15-camshaft_part.SLDPRT
11.0 x 16.0 x 11.0 mm
