ericjhoh/5-DOF-Arm/CAD/5-DOF Arm/gripper+camera+linkage/models/parts/RB9.01.060.074 Camera holder.STL

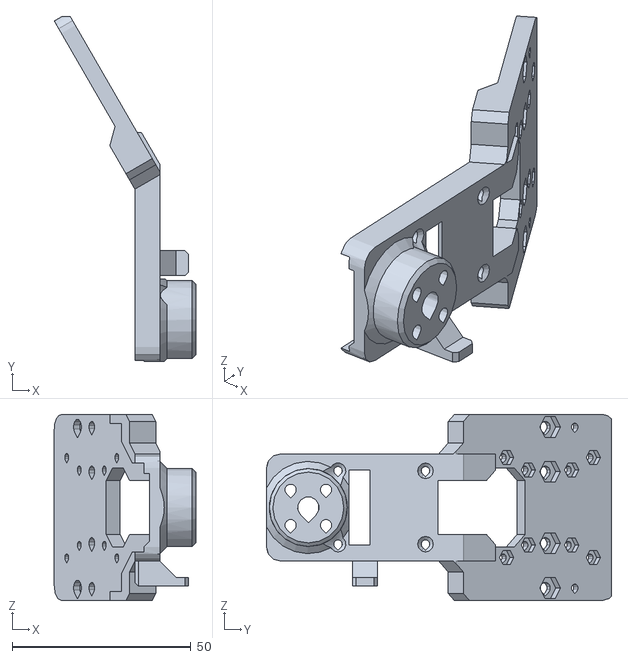
[picture p53: CAD file, 2026-09-18]
CAD/5-DOF Arm/gripper+camera+linkage/models/parts/RB9.01.060.074 Camera holder.STL
39.6 x 96.5 x 52.0
