ericjhoh/5-DOF-Arm/CAD/5-DOF Arm/gripper+camera+linkage/models/parts/RB9.01.060.110 D405 holder.STL

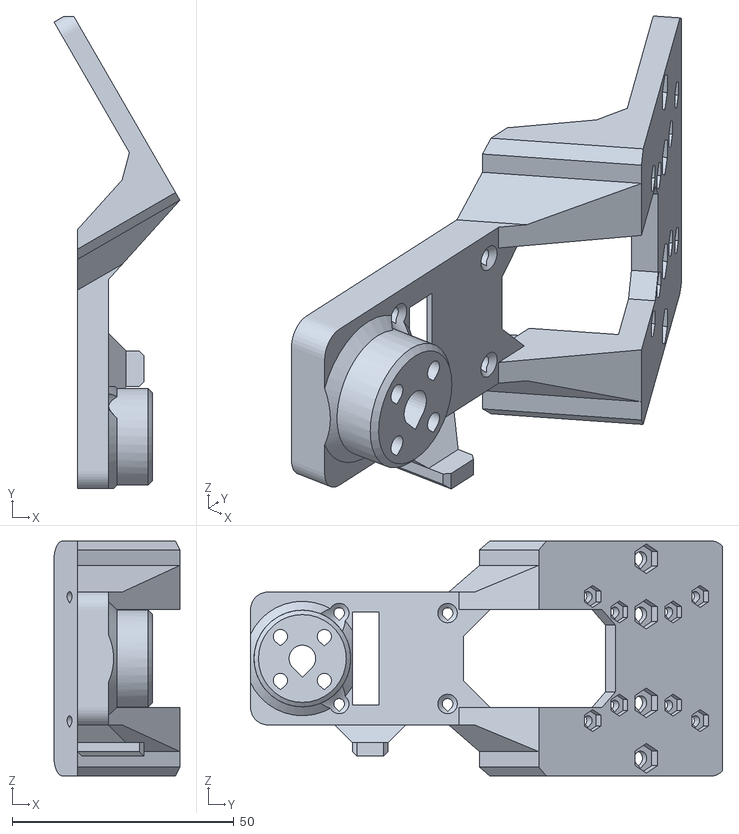
[picture p55: CAD file, 2026-09-18]
CAD/5-DOF Arm/gripper+camera+linkage/models/parts/RB9.01.060.110 D405 holder.STL
28.4 x 106.5 x 53.0
