ericjhoh/5-DOF-Arm/CAD/5-DOF Arm/gripper+camera+linkage/models/parts/Gripper test plate star holes 6.0-6.3.STL

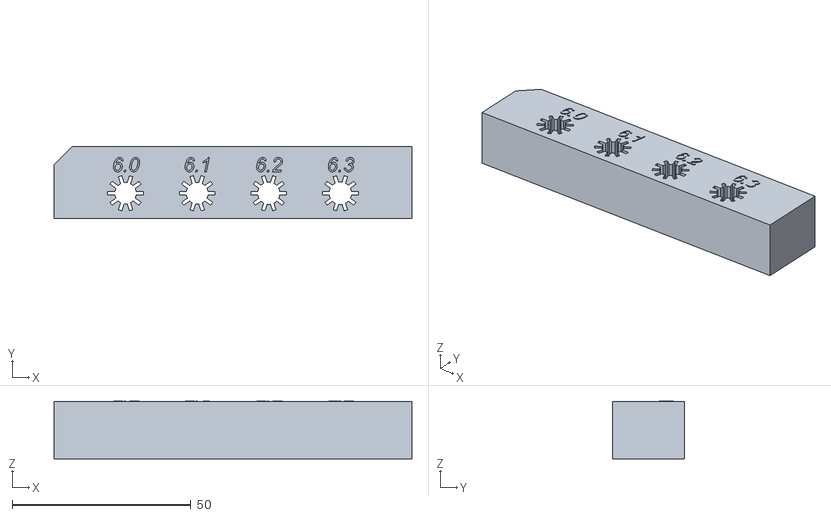
[picture p56: CAD file, 2026-09-18]
CAD/5-DOF Arm/gripper+camera+linkage/models/parts/Gripper test plate star holes 6.0-6.3.STL
100.0 x 20.0 x 16.2
