ericjhoh/5-DOF-Arm/CAD/5-DOF Arm/gripper+camera+linkage/models/parts/RB9.01.062.021 (D6.1) Clamp.STL

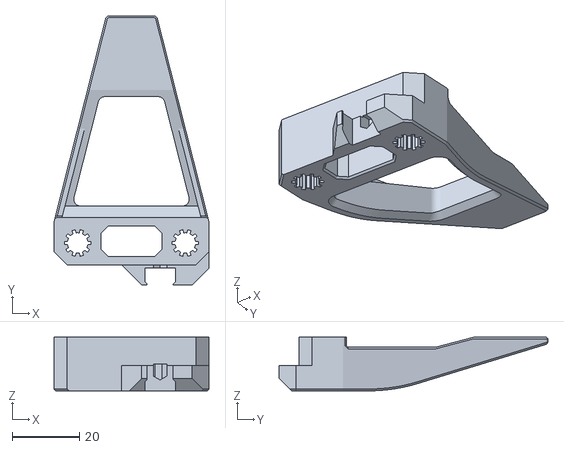
[picture p57: CAD file, 2026-09-18]
CAD/5-DOF Arm/gripper+camera+linkage/models/parts/RB9.01.062.021 (D6.1) Clamp.STL
46.0 x 80.0 x 16.0
