ericjhoh/5-DOF-Arm/CAD/5-DOF Arm/URDF/5-DOF_Arm_ASY.SLDASM

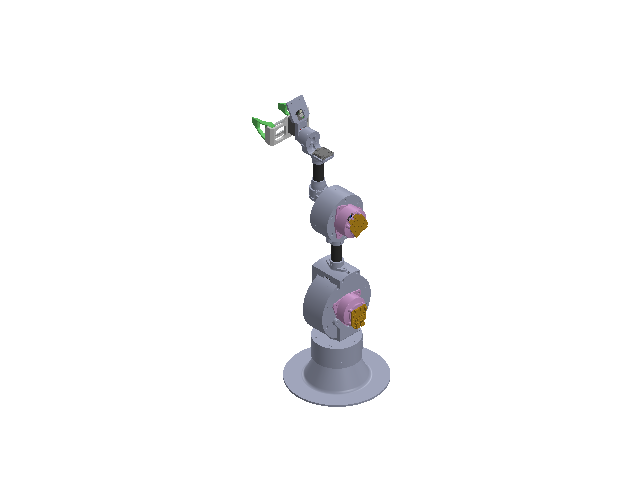
[picture p61: CAD file, 2026-11-08]
CAD/5-DOF Arm/URDF/5-DOF_Arm_ASY.SLDASM
base_support
Wires.stp x 3
Stator-0.stp x 3
DIN471-005-00,60.stp x 3
Magnet (1).stp x 3
Axis-1.stp x 3
Ring.stp x 3
Magnet.stp x 42
M3x3 v2.stp x 3
Rotor-2.stp x 3
Component10.stp x 3
Cables-3.stp x 3
Cables-4.stp x 3
Cables-5.stp x 3
base.stp x 3
625Z.stp x 6
motor housing x 3
coupler x 3
20210124-moteus-controller-r45-mechanical x 3
15-middle_wall x 2
15-output_wall x 4
shoulder_bolt x 20
15-camshaft_part x 8
bearings x 189
spacers x 264
ring_pin x 85
15-cycloidal_disk_ethan_printing x 2
15-cycloidal_disk_ethan2_printing x 2
15-output_flange x 4
15-J1-output
30-middle_wall
30-output_wall x 2
30-camshaft_part x 4
30-cycloidal_disk x 2
30-output_flange x 2
30_attachement2
30-attachment1
tube_connector x 2
carbon_fiber_tube
j4_connector
moteus_c1 x 2
j5_connector_2
j5_connector_1
carbon_fiber_tube_j4j5
GIM3505-8-3D-Model x 2
ZK_122_STS3215_Servo.STEP
SG-ZIJI_15_STS3215_Servo.STEP
XG-ZIJI_16_STS3215_Servo.STEP
Main Wheel_STS3215_Servo.STEP
pan head cross recess screw_din_DIN EN ISO 7045 - M3 x 4 - Z - 4N.STEP
0022035035.STEP x 2
0050375033_______.STEP
RB9.01.062.010 Main frame_125 follower.STEP
RB9.01.062.020 Clamp.STEP x 2
RB9.01.062.030 Gear rack_m0.8.STEP x 2
RB9.01.062.040 Gear for gripper_ISO - Spur gear 0.8M 18T 20PA 5FW ---S18B10H8L6.0S1.STEP
RB9.01.060.090 Camera spacer.STEP
Rod d6_125.STEP x 2
Bearing_MF106 10_6_3.STEP x 2
countersunk flat head cross recess screw_din_DIN EN ISO 7046-1 - M2 x 8 - Z - 8N.STEP x 3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
