ericjhoh/5-DOF-Arm/CAD/GearBoxes/15-1 Cycloidal Gearbox/15_1_Gearbox_ASY.SLDASM

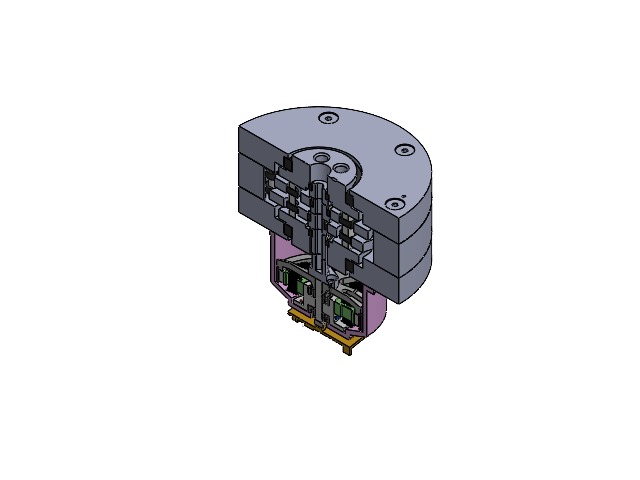
[picture p62: CAD file, 2026-11-13]
CAD/GearBoxes/15-1 Cycloidal Gearbox/15_1_Gearbox_ASY.SLDASM
15-camshaft_part x 4
bearings x 50
spacers x 69
ring_pin x 22
15-cycloidal_disk_ethan_printing
15-cycloidal_disk_ethan2_printing
15-output_flange x 2
15-middle_wall
15-output_wall x 2
shoulder_bolt x 6
Wires.stp
Stator-0.stp
DIN471-005-00,60.stp
Magnet (1).stp
Axis-1.stp
Ring.stp
Magnet.stp x 14
M3x3 v2.stp
Rotor-2.stp
Component10.stp
Cables-3.stp
Cables-4.stp
Cables-5.stp
base.stp
625Z.stp x 2
motor housing
coupler
20210124-moteus-controller-r45-mechanical
