ericjhoh/5-DOF-Arm/CAD/GearBoxes/30-1 Cycloidal Gearbox/30_1_Gearbox_ASY.SLDASM

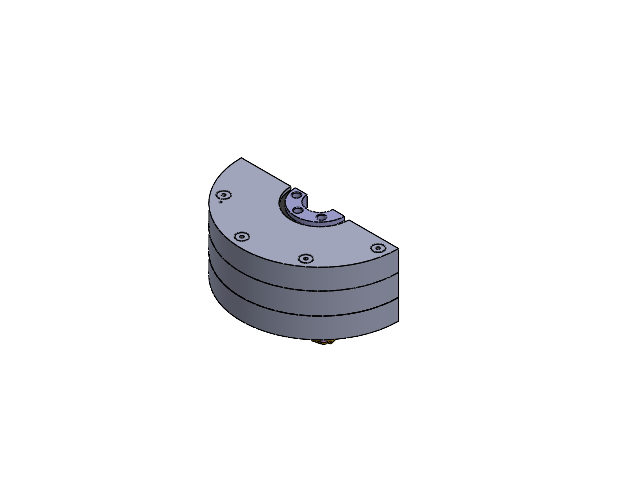
[picture p63: CAD file, 2026-11-13]
CAD/GearBoxes/30-1 Cycloidal Gearbox/30_1_Gearbox_ASY.SLDASM
ring_pin x 39
bearings x 84
spacers x 120
30-camshaft_part x 4
30-cycloidal_disk x 2
30-output_flange x 2
30-middle_wall
30-output_wall x 2
shoulder_bolt x 8
Wires.stp
Stator-0.stp
DIN471-005-00,60.stp
Magnet (1).stp
Axis-1.stp
Ring.stp
Magnet.stp x 14
M3x3 v2.stp
Rotor-2.stp
Component10.stp
Cables-3.stp
Cables-4.stp
Cables-5.stp
base.stp
625Z.stp x 2
motor housing
coupler
20210124-moteus-controller-r45-mechanical
