ericjhoh/5-DOF-Arm/CAD/GearBoxes/Motor Housing/30-motor+housing+coupler_ASY.SLDASM

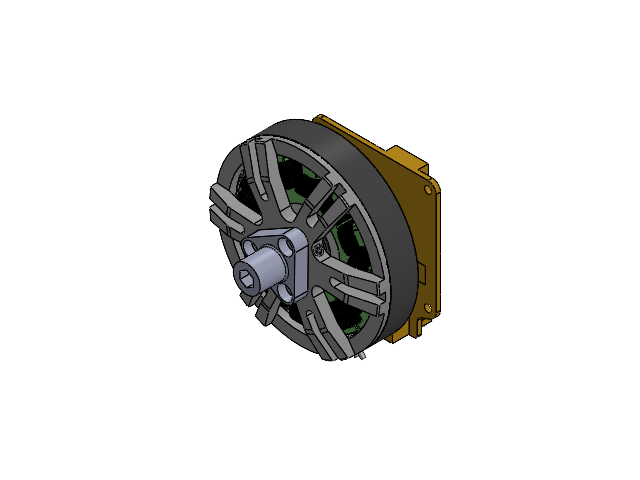
[picture p65: CAD file, 2026-11-13]
CAD/GearBoxes/Motor Housing/30-motor+housing+coupler_ASY.SLDASM
Wires.stp
Stator-0.stp
DIN471-005-00,60.stp
Magnet (1).stp
Axis-1.stp
Ring.stp
Magnet.stp x 14
M3x3 v2.stp
Rotor-2.stp
Component10.stp
Cables-3.stp
Cables-4.stp
Cables-5.stp
base.stp
625Z.stp x 2
coupler
20210124-moteus-controller-r45-mechanical
