ericjhoh/5-DOF-Arm/CAD/GearBoxes/Shared_Parts/roller_pin_ASY.SLDASM

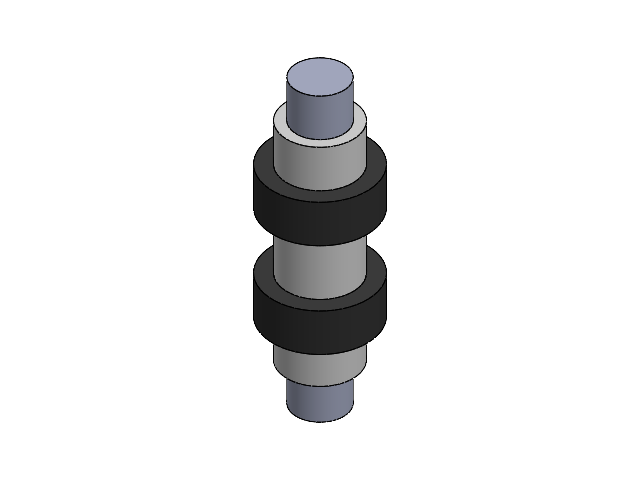
[picture p66: CAD file, 2026-11-13]
CAD/GearBoxes/Shared_Parts/roller_pin_ASY.SLDASM
ring_pin
bearings x 2
spacers x 3
