ericjhoh/5-DOF-Arm/CAD/5-DOF Arm/gripper+camera+linkage/camera+gripper+connector.SLDASM

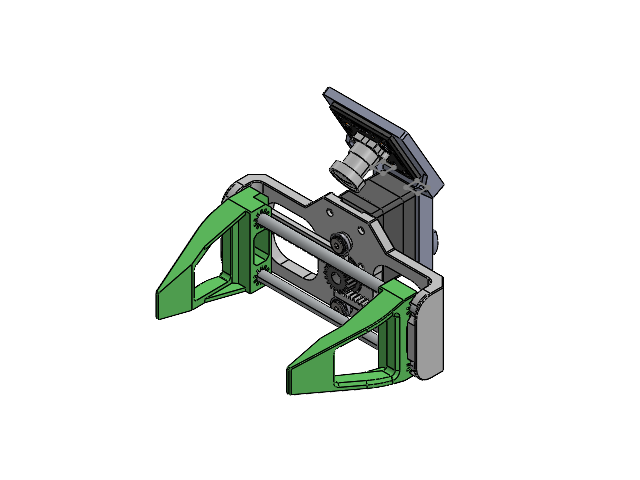
[picture p67: CAD file, 2026-09-18]
CAD/5-DOF Arm/gripper+camera+linkage/camera+gripper+connector.SLDASM
ZK_122_STS3215_Servo.STEP
SG-ZIJI_15_STS3215_Servo.STEP
XG-ZIJI_16_STS3215_Servo.STEP
Main Wheel_STS3215_Servo.STEP
pan head cross recess screw_din_DIN EN ISO 7045 - M3 x 4 - Z - 4N.STEP
0022035035.STEP x 2
0050375033_______.STEP
RB9.01.062.010 Main frame_125 follower.STEP
RB9.01.062.020 Clamp.STEP x 2
RB9.01.062.030 Gear rack_m0.8.STEP x 2
RB9.01.062.040 Gear for gripper_ISO - Spur gear 0.8M 18T 20PA 5FW ---S18B10H8L6.0S1.STEP
RB9.01.060.090 Camera spacer.STEP
Rod d6_125.STEP x 2
Bearing_MF106 10_6_3.STEP x 2
countersunk flat head cross recess screw_din_DIN EN ISO 7046-1 - M2 x 8 - Z - 8N.STEP x 3
socket countersunk head screw_din_DIN 7991 - M4 x 8 --- 8N.STEP x 2
B0447(UC-A52) Include device.STEP
B0454_1.STEP
connector
