ericjhoh/5-DOF-Arm/CAD/5-DOF Arm/gripper+camera+linkage/B0454.SLDASM

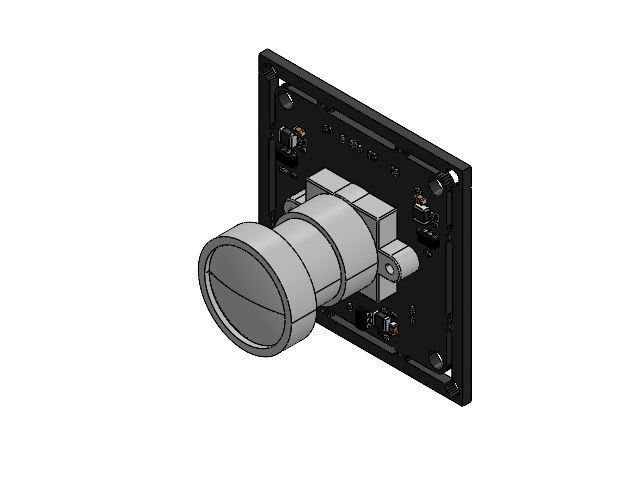
[picture p69: CAD file, 2026-09-18]
CAD/5-DOF Arm/gripper+camera+linkage/B0454.SLDASM
B0447(UC-A52) Include device.STEP
B0454_1.STEP
