ericjhoh/5-DOF-Arm/CAD/GearBoxes/30-1 Cycloidal Gearbox/Gearbox/30-camshaft_ASY.SLDASM

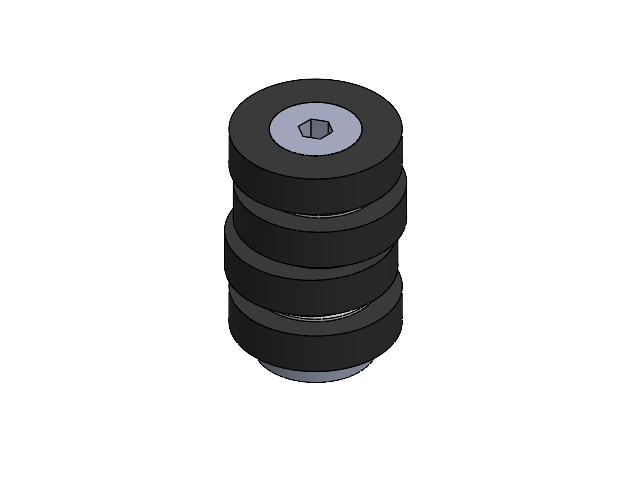
[picture p70: CAD file, 2026-11-13]
CAD/GearBoxes/30-1 Cycloidal Gearbox/Gearbox/30-camshaft_ASY.SLDASM
30-camshaft_part x 4
bearings x 4
spacers x 3
