ericjhoh/5-DOF-Arm/CAD/GearBoxes/30-1 Cycloidal Gearbox/Gearbox/Attachments/30-attachment_ASY.SLDASM

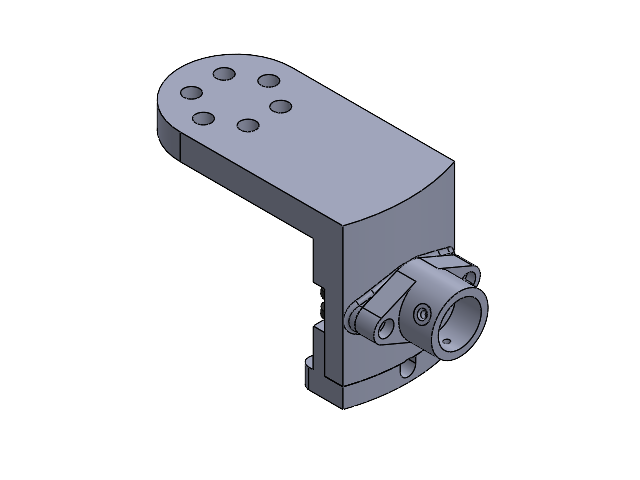
[picture p71: CAD file, 2026-11-13]
CAD/GearBoxes/30-1 Cycloidal Gearbox/Gearbox/Attachments/30-attachment_ASY.SLDASM
30_attachement2
30-attachment1
ring_pin x 2
bearings x 5
spacers x 6
tube_connector
