ericjhoh/5-DOF-Arm/CAD/GearBoxes/15-1 Cycloidal Gearbox/Gearbox/15-disk+output+rollers+flanges_ASY.SLDASM

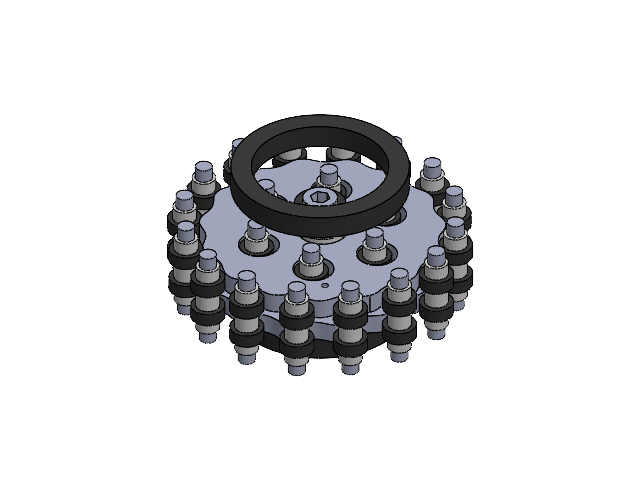
[picture p73: CAD file, 2026-11-13]
CAD/GearBoxes/15-1 Cycloidal Gearbox/Gearbox/15-disk+output+rollers+flanges_ASY.SLDASM
15-camshaft_part x 4
bearings x 50
spacers x 69
ring_pin x 22
15-cycloidal_disk_ethan_printing
15-cycloidal_disk_ethan2_printing
15-output_flange x 2
