ericjhoh/5-DOF-Arm/CAD/GearBoxes/30-1 Cycloidal Gearbox/Gearbox/30-disk+output+rollers_ASY.SLDASM

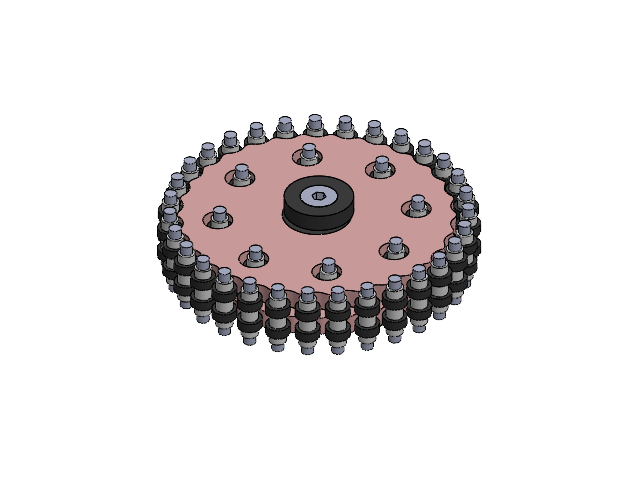
[picture p74: CAD file, 2026-11-13]
CAD/GearBoxes/30-1 Cycloidal Gearbox/Gearbox/30-disk+output+rollers_ASY.SLDASM
ring_pin x 39
bearings x 82
spacers x 120
30-camshaft_part x 4
30-cycloidal_disk x 2
