ericjhoh/5-DOF-Arm/CAD/GearBoxes/15-1 Cycloidal Gearbox/Gearbox/15-camshaft_ASY.SLDASM

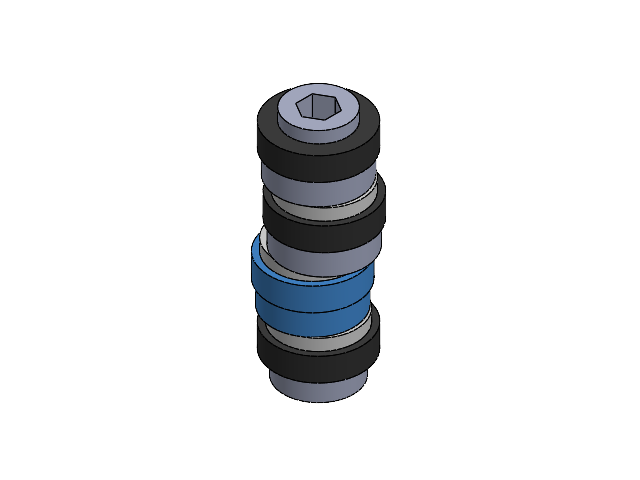
[picture p76: CAD file, 2026-11-08]
CAD/GearBoxes/15-1 Cycloidal Gearbox/Gearbox/15-camshaft_ASY.SLDASM
15-camshaft_part x 4
bearings x 4
spacers x 3
