ericjhoh/5-DOF-Arm/CAD/GearBoxes/30-1 Cycloidal Gearbox/Gearbox/30-gearbox_ASY.SLDASM

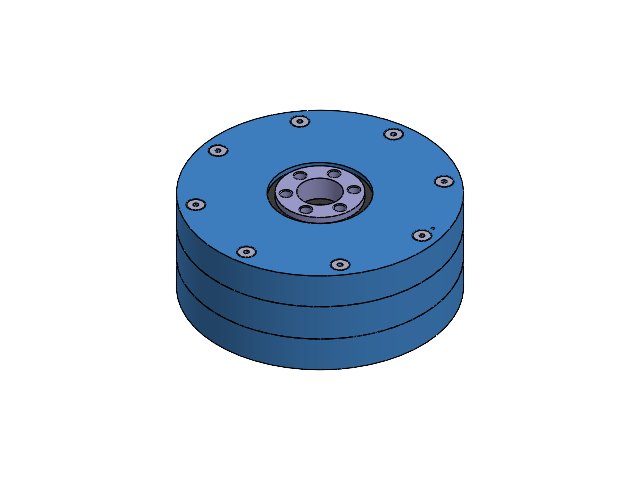
[picture p77: CAD file, 2026-11-13]
CAD/GearBoxes/30-1 Cycloidal Gearbox/Gearbox/30-gearbox_ASY.SLDASM
ring_pin x 39
bearings x 84
spacers x 120
30-camshaft_part x 4
30-cycloidal_disk x 2
30-output_flange x 2
30-middle_wall
30-output_wall x 2
shoulder_bolt x 8
