ericjhoh/5-DOF-Arm/CAD/GearBoxes/15-1 Cycloidal Gearbox/Gearbox/15-disk+output_ASY_ethan.SLDASM

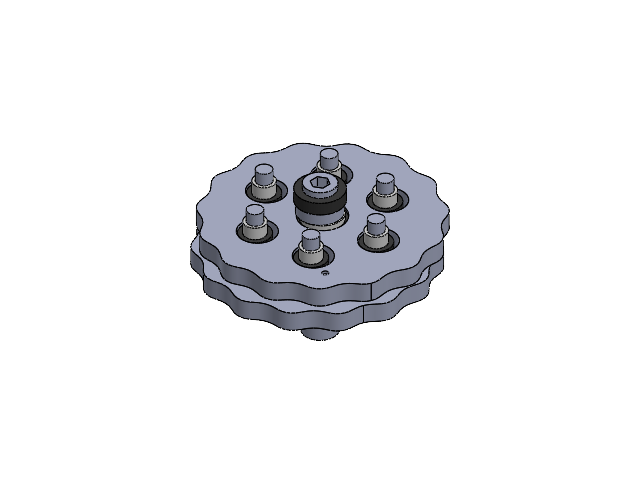
[picture p78: CAD file, 2026-11-08]
CAD/GearBoxes/15-1 Cycloidal Gearbox/Gearbox/15-disk+output_ASY_ethan.SLDASM
15-camshaft_part x 4
bearings x 16
spacers x 21
ring_pin x 6
15-cycloidal_disk_ethan_printing
15-cycloidal_disk_ethan2_printing
