ericjhoh/5-DOF-Arm/(list of files, cad)

Other CAD files:
CAD/5-DOF Arm/URDF/5-DOF_Arm_ASY/meshes/base_link.STL
CAD/GearBoxes/15-1 Cycloidal Gearbox/Gearbox/Stls/15-J1-output.3mf
CAD/GearBoxes/30-1 Cycloidal Gearbox/Gearbox/Stls/30_attachement2.STL
CAD/GearBoxes/30-1 Cycloidal Gearbox/Gearbox/Stls/30-attachment1.STL
CAD/5-DOF Arm/tube_connector.SLDPRT
CAD/GearBoxes/15-1 Cycloidal Gearbox/Gearbox/15-output_wall.SLDPRT
CAD/5-DOF Arm/gripper+camera+linkage/models/parts/RB9.01.062.030 Gear rack.STL
CAD/GearBoxes/15-1 Cycloidal Gearbox/Gearbox/15-middle_wall_print.SLDPRT
CAD/5-DOF Arm/gripper+camera+linkage/models/parts/RB9.01.062.021 (D6.3) Clamp.STL
CAD/5-DOF Arm/gripper+camera+linkage/models/parts/RB9.01.062.021 (D6.0) Clamp.STL
CAD/5-DOF Arm/gripper+camera+linkage/models/parts/RB9.01.060.090 Camera spacer.STL
CAD/5-DOF Arm/gripper+camera+linkage/models/parts/RB9.01.062.040 Gear.STL
CAD/5-DOF Arm/stls/base_support.STL
CAD/5-DOF Arm/stls/j4j5 - j4_connector-1.STL
CAD/5-DOF Arm/stls/tube_connector.STL
CAD/GearBoxes/15-1 Cycloidal Gearbox/Gearbox/Stls/15-J1-output.STL
CAD/GearBoxes/15-1 Cycloidal Gearbox/Gearbox/Stls/15-output_flange.STL
CAD/GearBoxes/15-1 Cycloidal Gearbox/Gearbox/Stls/15-output_wall.STL
