ericjhoh/5-DOF-Arm/Claude outputs/rbtarm_LeRobot_Software_Stack_Guide.docx

# rbtarm — LeRobot Software Stack Guide

Nov 13, 2026 · @Eric

## Overview

rbtarm is the software that makes my custom 5-DOF arm a first-class LeRobot robot, so I can teleoperate it, record demonstrations, train an ACT policy and run it autonomously with LeRobot's own CLI tools. It is about 4,000 lines of Python in three plugin packages, and it never modifies the LeRobot source.

The 30-second version: LeRobot assumes hobby serial servos; my arm uses mjbots moteus brushless controllers on a CAN-FD bus behind custom cycloidal gearboxes. rbtarm bridges that gap: a custom motor bus that speaks moteus over an fdcanusb, a follower robot class that adds calibration, gravity compensation and safety limits, and two teleoperators (keyboard and Xbox gamepad) that produce smooth absolute joint targets. With it, an ACT policy trained on 30 teleoperated demos completed pick-and-place in 9 of 10 trials.

How a control tick flows (30 Hz):

1. The teleoperator (or the trained policy) produces a target angle for each joint plus a gripper opening.
2. The follower clamps it to the calibrated soft limits and to a per-tick step cap, and computes a gravity feedforward torque from the measured pose.
3. The motor bus converts degrees to output revolutions and sends all five position commands in one CAN-FD round trip, which also returns every joint's state.
4. Each moteus controller runs its own fast position loop (kp, kd, torque limit, velocity and acceleration limits) between host ticks.
5. The follower returns the observation (joint angles, gripper, camera frames) that LeRobot logs into the dataset.

The main parts, from the hardware up:

Layer | Code | Job
Hardware | 5 moteus controllers, fdcanusb, Feetech STS3215 gripper, 2 cameras | Joint torque control, gripper, vision
Transport | async_loop.py | Runs the async moteus API on a background thread behind LeRobot's synchronous API
Motor bus | moteus_bus.py (MoteusMotorsBus) | Degrees in, CAN commands out; batching, state cache, keepalive, dropout handling
Robot | rbtarm_follower.py (RbtarmFollower) | Observations/actions, calibration, homing, soft limits, gravity feedforward, gripper safety
Physics model | gravity.py | Feedforward torque that holds the arm's own weight
Teleop | keyboard and gamepad packages | Jog inputs integrated into absolute targets, leashed to the measured pose
Glue | pose_hint.py, record_events.py | Lets the teleop see the robot's pose and limits; lets gamepad buttons control recording

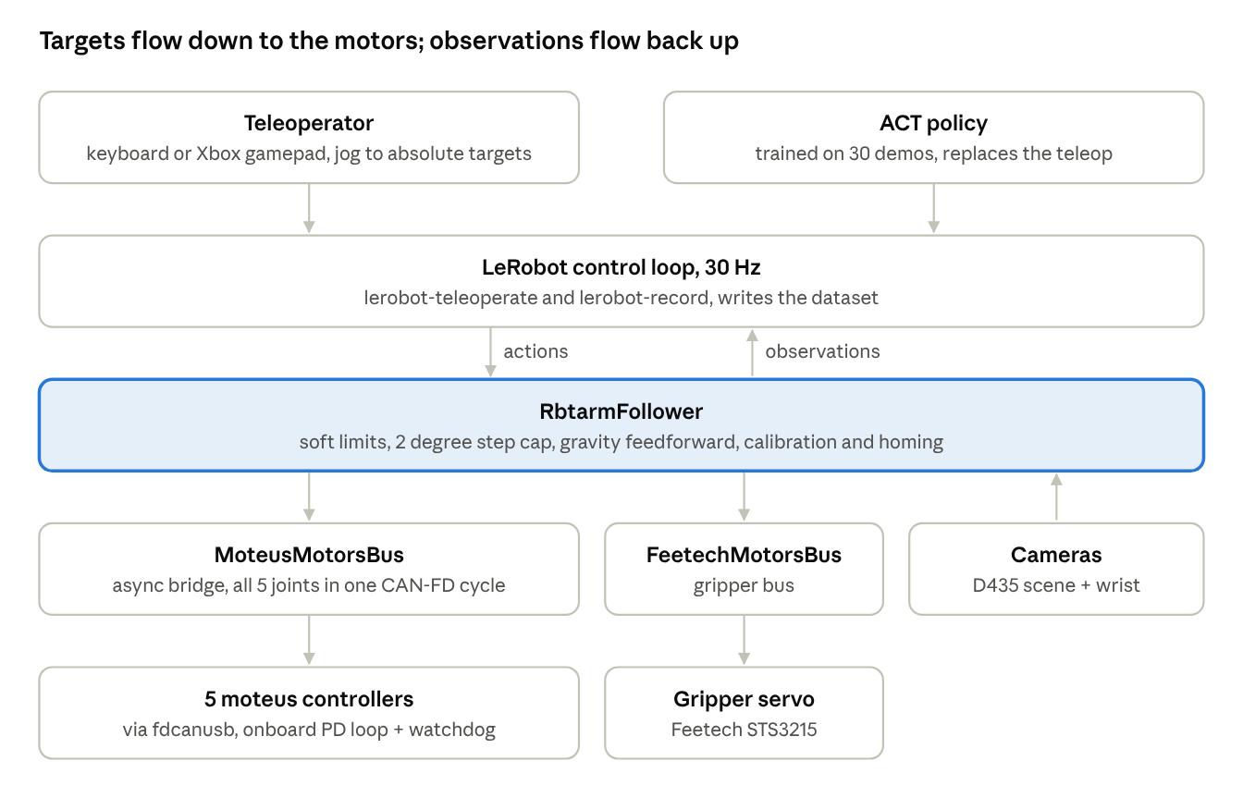
[picture p80: figure]
rbtarm architecture · 5 layers from action source to hardware

rbtarm architecture · 5 layers from action source to hardware

The follower is the hub: everything above it speaks LeRobot's synchronous API, everything below it is device-specific, and the pose and limits it publishes each tick are what the teleop leash reads.

## Hardware and communication

All five arm joints sit on one CAN-FD bus through a single USB adapter, and the gripper has its own serial bus; the host talks to both at 30 Hz while the controllers close the fast loops themselves.

Device | Joints | Link to host | Notes
moteus r4.11 + MJ5208 | J1 shoulder_pan (CAN id 1), J2 shoulder_lift (2), J3 elbow_flex (3) | CAN-FD, 5 Mbps | Custom cycloidal reducers: 15:1, 30:1, 15:1
moteus-c1 + GIM3505-8 | J4 wrist_flex (4, the forearm roll), J5 wrist_roll (5) | Same CAN-FD bus | 8:1 planetary; reads the motor's own AS5047P encoder on AUX2
mjbots fdcanusb | — | USB serial | Auto-detected at /dev/serial/by-id/*fdcanusb*
Feetech STS3215 bus servo | gripper | Waveshare serial bus board, /dev/ttyACM0 | Position 0–100 (closed to open)
Intel RealSense D435 | scene camera | USB | 640×480 at 30 fps
Arducam 5 MP UVC | wrist camera | USB | Mounted upside down: rotation: ROTATE_180

Units and frames. The gear ratio is flashed on each controller (motor_position.rotor_to_output_ratio), so moteus reports output revolutions. The host converts to degrees at the joint with a scale, a sign and the calibration offset. Joint names follow LeRobot's SO-arm convention, so wrist_flex is my forearm roll (J4) and wrist_roll is J5.

What the controller does vs. the host. Each moteus runs commutation, current control and the position PID onboard at kHz rates. The host sends a target position, a velocity, a feedforward torque, torque/velocity/acceleration limits and a watchdog timeout in each command, then reads back position, velocity, torque and fault state in the same round trip.

Two settings that matter on every controller:

- servo.default_timeout_mode 12 (ZERO_VELOCITY): if the host goes silent, the joint holds damped instead of going limp. moteus has no brake, so mode 0 would drop the arm.
- servopos.position_min/max: on-controller position limits, the last line of defense if the host dies. They live in the calibrated output frame, so they are flashed after calibration (the calibrate step prints the exact conf set lines).

## Package layout and plugin discovery

rbtarm ships as three out-of-tree pip packages that LeRobot discovers automatically by name, so every stock command (lerobot-calibrate, lerobot-teleoperate, lerobot-record) works with --robot.type=rbtarm_follower without touching LeRobot itself.

Package | Registers | Main files
lerobot_robot_rbtarm | --robot.type=rbtarm_follower | rbtarm_follower.py, moteus_bus.py, async_loop.py, gravity.py, tuning.py, pose_hint.py, config_rbtarm_follower.py
lerobot_teleoperator_rbtarm_keyboard | --teleop.type=rbtarm_keyboard | rbtarm_keyboard.py, keymap.py, key_backends.py
lerobot_teleoperator_rbtarm_gamepad | --teleop.type=rbtarm_gamepad | rbtarm_gamepad.py, gamepad_backend.py, record_events.py

How discovery works. LeRobot's register_third_party_plugins() imports any installed distribution whose name starts with lerobot_robot_ or lerobot_teleoperator_. Each package's config class registers itself with draccus (@RobotConfig.register_subclass("rbtarm_follower")), which is what makes the --robot.type flag resolve.

Install detail worth knowing. The packages are installed editable with uv pip install --no-deps. Without --no-deps, uv re-resolves lerobot>=0.6.2 and can replace my editable LeRobot checkout with a PyPI wheel.

Supporting scripts (in scripts/), used in this order during bring-up:

1. bringup_01_spin_one_motor.py: one joint, bare moteus; checks wiring, CAN id, direction and output scaling.
2. bringup_02_bus_smoke.py: all five ids at 30 Hz through the bus and the async bridge.
3. bringup_03_robot_no_cameras.py: the whole follower, no cameras.
4. bringup_04_gravity_check.py: compares the gravity model with the torque the controllers report while holding a pose.
5. find_uvc_cameras.py, calibrate_gripper.py, calibrate_limits_teleop.py: camera discovery, gripper-only calibration, and setting joint limits by driving the arm.

## The follower robot and motor bus

RbtarmFollower implements LeRobot's Robot contract (connect, calibrate, get_observation, send_action, disconnect) on top of two buses: my MoteusMotorsBus for the five joints and LeRobot's stock FeetechMotorsBus for the gripper.

### MoteusMotorsBus: one round trip per tick

The bus subclasses LeRobot's MotorsBusBase, not MotorsBus, because the latter is tied to the Dynamixel/Feetech register-table protocol and has nothing to offer a CAN device (LeRobot's own Robstride and Damiao CAN buses make the same choice).

- Batching: every joint's command goes into a single fdcanusb cycle(), and each position command carries query=True, so the write also returns fresh state. One bus transaction serves all five joints.
- Units: positions in degrees, velocities in deg/s, torques in N·m, with no control table or normalization. read/write use a small fixed vocabulary (Present_Position, Goal_Position, etc.).
- State cache: decoded replies are cached per joint with a timestamp. state_max_age_s can reuse a fresh-enough reading to halve bus traffic; the default 0 always re-queries.
- Dropouts: a timed-out cycle is retried once, because one lost frame costs the full response timeout. Joints that still don't answer keep their last state, are counted, and are logged at most once a second with a hint about CAN wiring or termination.
- Explicit velocity: every position command sets velocity explicitly. Leaving it None makes moteus keep the last commanded velocity, and the joint creeps.

### The async bridge (async_loop.py)

The moteus Python API is entirely asyncio; LeRobot's robot API is entirely synchronous. AsyncLoopThread owns one event loop running forever on a daemon thread, and run(coro, timeout) submits work to it and blocks the caller.

- The fdcanusb transport must be created and used on that same loop: it registers its serial file descriptor with the loop that is running when it is built, so building it anywhere else means bytes are never delivered.
- The loop runs continuously (run_forever), not pumped per call. A pumped loop let the serial buffer fill between ticks, which showed up as "every Nth read returns the previous tick's position."
- The timeout is enforced on the calling thread, so a hung USB device raises TimeoutError into the control loop instead of freezing it.

### Observations and actions

- Observation: shoulder_pan.pos … wrist_roll.pos in degrees, gripper.pos 0–100, plus one image per camera (scene, wrist). Cameras use read_latest(), so a slow frame never stalls the control loop.
- Action: the same six .pos keys. An optional out-of-band estop flag rides along but is left out of action_features, so it never reaches the dataset.
- send_action returns the action actually sent after clamping, which is what LeRobot records.

### Calibration and homing

The joints have no absolute encoder on the gearbox output, which drives most of this design.

1. Zero pose: with torque off, I hold the arm in its reference pose and the bus calls moteus set_output_nearest(0) on each controller. Any residual is stored as the homing offset.
2. Range of motion: I move each joint through its full range by hand while the bus records min and max. Ranges, with a 2° margin, become the soft limits.
3. Gripper: it can't be back-driven, so the servo calibrates itself. It drops to 15% torque and steps toward each end until the encoder stops moving, tracking unwrapped counts so a stroke of about 3,300 of 4,096 counts can cross the encoder boundary. The final offset centers the stroke in the encoder range, and a refine prompt fixes a stop the stall detector got wrong.
4. Homing on every connect: after a power cycle, a controller behind a 30:1 gearbox knows the output only modulo one rotor turn (12°). connect() asks me to place the arm in the reference pose, within ±6°, and set_output_nearest(0) snaps to the exact consistent position. Joints that still read more than 10° off trigger a warning.

Shortcuts: a recalibrates the arm only and keeps the gripper; z re-teaches only the zero pose and shifts the stored ranges so they stay at the same physical positions.

## Control: gains, gravity feedforward and smooth motion

The controllers run a PD position loop on the output angle, and the host adds two feedforward terms (gravity torque and goal velocity) so the loop only corrects small residuals.

### Position loop gains

moteus ships with kp = 4 N·m per revolution, tuned for direct drive. With the gear ratio configured, the loop works in output revolutions, so a 2° error produces only 4 × 2/360 ≈ 0.02 N·m: the arm is limp and never moves. I retuned each controller (starting near kp = 150, about 0.4 N·m per degree), kept ki = 0, and let feedforward handle gravity.

- Tune one joint at a time with the arm fully assembled, so gains match the real inertia and load, and physically support the arm throughout.
- Order: tip to base (wrist_roll → shoulder_pan), so mistakes happen on the lightest joints first.
- Raise kp until a small step rings for 1–2 cycles, then back off by a third. Raise kd only for a real, slow-decaying ring.
- Key diagnosis: torque chattering rail to rail at every kp is kd amplifying a noisy velocity signal, not a kp problem. Heavy proximal joints can use kd ≈ 4; light wrist joints start near 0.05.
- Per-joint host limits in JointTuning: max_torque (default 2 N·m; I raised the shoulder to 10 and the elbow to 5), velocity_limit_deg_s, accel_limit_deg_s2, and kp_scale/kd_scale multipliers.

### Gravity feedforward (gravity.py)

With no integrator, a joint settles at target − τ_gravity / kp: always offset toward the ground. Instead of more kp or an integrator (which lags and winds up as the load changes with pose), I compute the gravity torque from a mass model every tick and send it as moteus feedforward_torque.

For the two pitch joints, each mass contributes its weight times its horizontal distance from the joint axis:

\tau_j = g \sum_k m_k \, x_{jk}

J4 rolls the forearm about its own axis, and the gripper hangs perpendicular to it, so J4 sees a pendulum load:

\tau_4 = m_{hand} \, g \, c_{hand} \, \sin(\theta_{hand}) \, \cos(\theta_{forearm})

That is zero with the hand hanging straight down or the forearm vertical, and largest with the forearm level and the hand swung sideways. Base yaw sees no gravity torque.

- The model is a handful of numbers per link (mass, center-of-mass distance, length, direction, pitch at zero), measured with a ruler and a scale. The values that first moved every joint freely (2026-09-17): upper segment 0.900 kg at 0.240 m, forearm 0.478 kg at 0.075 m (0.150 m long), hand 0.192 kg at 0.05 m.
- It is computed from the measured pose, not the goal, because that is the weight actually hanging off each joint.
- bringup_04_gravity_check.py validates it: while holding a pose, the torque each controller reports is the gravity torque, so measured minus model is the model error. Tune masses until the residual is small across poses, then raise scale from 0.7 to 1.0.
- Clamped by gravity.max_torque_nm and again by each joint's max_torque.

### Smooth jogging: goal-velocity feedforward

A keyboard jog at 15°/s and 30 Hz is a staircase of 0.5° steps. Sent with velocity = 0, moteus plans a stop at every step, so the joint brakes 30 times a second. The bus estimates how fast each goal is moving from consecutive commands (low-pass filtered) and sends that as the command velocity, so the controller extrapolates between ticks and the staircase becomes a ramp. A goal that stops changing decays to zero velocity within a few ticks; the watchdog bounds how far a target can run on.

Other smoothing levers: a higher --fps (60) halves the step size; per-joint velocity and acceleration limits round off starts and stops; turning off --display_data removes loop jitter.

## Teleoperation

Both teleoperators turn operator input into jog rates, integrate them into absolute joint targets, and keep those targets leashed to where the arm actually is. I recorded my 30 demonstrations with the Xbox controller.

### The jog core

- Seeding: on its first tick the teleop reads the arm's measured pose and starts its targets there. Starting from zero would command, say, a 75° step on the elbow.
- Integration: each tick adds rate × dt × speed multiplier to the target, with per-joint speed scales (e.g. 0.5 for the heavy shoulder joints).
- Leash: every target is kept within target_lead_deg (10°; gripper 25%) of the measured position, and bounded by the robot's own soft limits. Without it, holding a key against a limit wound the target far past it, so reversing did nothing until it unwound and home seemed to fix itself seconds later.
- Commands: home (ramp all joints to zero), resync (snap targets to the measured pose), freeze, speed up/down, e-stop and clear e-stop.

### Keyboard (rbtarm_keyboard)

LeRobot's stock keyboard teleop uses pynput, which needs X11, and Ubuntu 26.04 ships Wayland only. So I wrote two Wayland-native backends:

- evdev (preferred): reads /dev/input/by-path/*-event-kbd directly. No window focus, works over SSH, and doesn't compete with lerobot-record's own terminal listener. Needs the input group.
- pygame (fallback): a small focused window that doubles as a jog HUD.

Keys: a/d pan, s/w shoulder, q/e elbow, k/i J4, j/l J5, u/o gripper, x e-stop, z clear, h home, g resync, space freeze.

### Xbox gamepad (rbtarm_gamepad)

Same jog core, driven over evdev (tested with an Xbox Wireless Controller over Bluetooth). Stick deflection sets the jog rate with a 0.15 deadzone and expo 2, so half deflection is quarter speed, which makes fine positioning much easier than on/off keys.

Input | Action
Left stick X / Y | shoulder_pan / shoulder_lift
Right stick Y / X | elbow_flex / J4 (wrist_flex)
LB / RB | J5 (wrist_roll) − / +
LT / RT (analog) | gripper close / open
A / B / X / Y | resync / e-stop / clear e-stop / home
D-pad up / down | speed multiplier
Start / Back / Xbox | next episode / re-record / stop recording

If the pad disconnects, the e-stop latches.

### Glue code: two LeRobot gaps I worked around

- The teleop can't see the robot. LeRobot's Teleoperator has no handle on the Robot, and the CLI gives no way to inject a processor that would. pose_hint.py is a small thread-safe in-process registry: the robot publishes its measured pose and soft limits each tick, and the teleop reads them for seeding and the leash. It is process-local by design and returns None across a client/server split, where max_relative_target remains the safety net.
- Gamepad buttons can't control recording. lerobot-record creates its episode-control flags inside its keyboard listener. record_events.py wraps that function when the record script is running and captures the same dict, so Start, Back and the Xbox button set the same flags as the arrow and Esc keys, and work without terminal focus.

## Safety layers

The arm has no brakes and can fall the moment torque is cut, so safety is layered from the teleop down to the controller firmware, and each layer still holds if the one above it fails.

Layer | Protects against | Where
Teleop leash (10°) + robot limits | Runaway targets winding past a limit | Teleop jog core, pose_hint
Soft joint limits (calibrated range − 2°) | Driving into a hard stop | RbtarmFollower.send_action
Step cap: 2° per tick (60°/s at 30 Hz) while recording | A policy or teleop jumping the arm | max_relative_target via LeRobot's ensure_safe_goal_position
Velocity, acceleration and torque ceilings per joint | Violent moves, overloads | JointTuning, sent in every command
Gravity feedforward clamp | A bad mass model pushing hard | gravity.max_torque_nm, then max_torque
Stale-reading guard (0.2 s) | Clamping a joint around a phantom position after dropouts | stale_joints(): joint keeps its last goal
Keepalive thread | Watchdog dropping the arm while the host is busy (video encoding, prompts, slow cameras) | Bus re-sends the held goal after 0.1 s of host silence
Watchdog (0.25 s) + timeout mode 12 | A crashed host | Controller holds damped instead of going limp
Fault check after every write | Controller faults going unnoticed | Register.FAULT
Bus-hang timeout | A wedged USB device freezing the loop | AsyncLoopThread.run raises TimeoutError
On-controller position limits | Everything above failing | servopos.position_min/max
E-stop (x, gamepad B, pad disconnect) | Operator emergency | Torque off on both buses

Energizing without a jump. On connect, every goal is seeded from the measured pose before torque comes on, so enabling the arm never steps.

Gripper protections, added after a 2026-09-18 incident where a hand-entered calibration range wider than the physical stroke drove the servo into its stop:

- Torque limit capped at 40% whenever the gripper is energized (calibration sweeps at 15%).
- The servo's goal is seeded to its present position before torque-on; Feetech otherwise drives to whatever stale goal is in its RAM.
- Connect is refused if the servo reads outside its calibrated range, which means the homing frame and the file disagree.
- Gripper goals are rate-limited to 5 units per tick, so a wrong target glides instead of snapping.

## From bring-up to a trained policy

The whole pipeline took six days, 16 to 21 September 2026, once the arm was assembled, and ended with an ACT policy completing pick-and-place in 9 of 10 trials.

1. Configure each controller in tview: rotor_to_output_ratio (1/gear ratio), default_timeout_mode 12, position gains.
2. Bring up with the four bringup_0x scripts: one motor, the bus at 30 Hz, the follower without cameras, the gravity check.
3. Tune each joint tip to base, then measure the gravity model and bring its scale to 1.0.
4. Calibrate with lerobot-calibrate --robot.type=rbtarm_follower: zero pose, ranges by hand (or by driving with calibrate_limits_teleop.py), the gripper sweep. Flash the printed servopos limits. The file lands in ~/.cache/huggingface/lerobot/calibration/robots/rbtarm_follower/<id>.json.
5. Teleoperate with lerobot-teleoperate and practice the task, first by keyboard, then by Xbox controller.
6. Record with lerobot-record: both cameras (D435 scene + wrist Arducam) at 640×480 and 30 fps, joint states and actions at 30 Hz, task "Pick up the cube and place it in the bin". I recorded 30 episodes.
7. Train an Action Chunking with Transformers (ACT) policy on those episodes with LeRobot's trainer: batch size 16, 75,000 steps.
8. Evaluate by running the policy on the real arm through the same follower, with the same limits and safety layers active: 9 of 10 trials succeeded (90%). Ten trials is a preliminary sample.

What a dataset frame holds: observation.state (5 joint angles in degrees + gripper 0–100), observation.images.scene, observation.images.wrist, and action (the 6 targets actually sent after clamping). Recording the clamped action, not the raw teleop target, means the policy learns commands the arm could really follow.

Why ACT: it predicts a chunk of future actions from images and joint state rather than one step at a time, which smooths motion and tolerates the small timing jitter of a 30 Hz Python loop. It is also LeRobot's well-supported baseline for small teleop datasets of a few dozen demos.

## Testing, design decisions and likely questions

The stack is tested without hardware: each package ships fake transports and input devices, so about 150 test functions (the README counts 136 tests) run in seconds with pytest, including an integration test that drives the follower and teleop through LeRobot's control loop and builds a real dataset frame.

Test file | Covers
test_moteus_bus.py | Command construction (exact kwargs via build_position_commands), unit conversion, dropouts, keepalive
test_robot.py | Connect, calibration, soft limits, stale joints, gripper protections, e-stop
test_gravity.py, test_units.py | Gravity model torques and signs, degree/revolution/torque conversions
test_jog_math.py, test_keymap.py, test_backends.py | Jog integration, leash, keymap, keyboard backends
test_gamepad_teleop.py, test_gamepad_backend.py | Stick shaping, buttons, record events, disconnect latch
tests/test_integration.py | Follower + teleop through the record loop, dataset frame

### Design decisions worth explaining

Decision | Why
Plugins, not a LeRobot fork | Stock CLI tools work unchanged and LeRobot upgrades don't break my code
MotorsBusBase, not MotorsBus | The serial register-table base class doesn't fit a CAN device
One persistent asyncio loop on a thread | moteus is async, LeRobot is sync; the serial reader only works on the loop that created it and only when the loop runs continuously
Fast loops on the controller, 30 Hz on the host | Python can't close a kHz loop; the host sends targets plus feedforward
Gravity feedforward instead of an integrator | Tracks a load that changes with pose; no lag or windup
Goal-velocity feedforward | Turns a 30 Hz staircase into a smooth ramp
Home on every connect | No output-side absolute encoder: after power-up the output is known only modulo one rotor turn
Record the clamped action | The policy learns commands the arm can actually execute
Many independent safety layers | No brakes; any single failure must not drop or crash the arm

### Likely questions

Why moteus instead of hobby servos? Torque control, backdrivability through low-ratio cycloidals, and high-rate onboard control, which imitation learning needs for smooth teleop and consistent timing. The cost was writing the bus driver myself.

What was the hardest bug? Two: the fdcanusb reader returning the previous tick's position, fixed by running the event loop continuously; and the arm being limp because stock gains were sized for direct drive, fixed by retuning in output units.

How do you know the gravity model is right? While holding a pose, the controllers' reported torque is the gravity torque, so I compare model to measurement across poses and tune the masses until the residual is small.

What happens if the laptop crashes mid-motion? Commands stop, the 0.25 s watchdog expires, and each controller drops into zero-velocity damped mode instead of going limp. On-controller position limits still apply.

What would you improve? Output-side absolute encoders on J1–J3 to remove manual homing and measure backlash directly; evaluation over 50+ trials with varied object positions; and a sim (the URDF already exists) for faster policy iteration.
