ericjhoh/5-DOF-Arm/CAD/5-DOF Arm/URDF/5-DOF_Arm_ASY/urdf/5-DOF_Arm_ASY.urdf

<?xml version="1.0" encoding="utf-8"?>
<!-- This URDF was automatically created by SolidWorks to URDF Exporter! Originally created by Stephen Brawner (brawner@gmail.com) 
     Commit Version: 1.6.0-4-g7f85cfe  Build Version: 1.6.7995.38578
     For more information, please see http://wiki.ros.org/sw_urdf_exporter -->
<robot name="5-DOF_Arm_ASY">
  <link name="base_link">
    <inertial>
      <origin xyz="-0.00663853071847152 0.254325881488244 4.81691010618269E-05" rpy="0 0 0" />
      <mass value="3.25995280603493" />
      <inertia ixx="0.00682886048664753" ixy="-6.8460186315741E-05" ixz="-1.91003128402673E-07" iyy="0.00575042818006955" iyz="-1.35715477402595E-06" izz="0.00454828827288072" />
    </inertial>
    <visual>
      <origin xyz="0 0 0" rpy="0 0 0" />
      <geometry>
        <mesh filename="package://5-DOF_Arm_ASY/meshes/base_link.STL" />
      </geometry>
      <material name="">
        <color rgba="0.752941176470588 0.752941176470588 0.752941176470588 1" />
      </material>
    </visual>
    <collision>
      <origin xyz="0 0 0" rpy="0 0 0" />
      <geometry>
        <mesh filename="package://5-DOF_Arm_ASY/meshes/base_link.STL" />
      </geometry>
    </collision>
  </link>
  <link name="shoulder_link">
    <inertial>
      <origin xyz="0.00455797125216986 0.113495824081398 1.30476163865285E-08" rpy="0 0 0" />
      <mass value="0.938949864287003" />
      <inertia ixx="0.0032722828750638" ixy="-1.30793334529102E-05" ixz="-7.39855429718349E-09" iyy="0.00173953615004112" iyz="-5.20558993645056E-08" izz="0.00173416735571836" />
    </inertial>
    <visual>
      <origin xyz="0 0 0" rpy="0 0 0" />
      <geometry>
        <mesh filename="package://5-DOF_Arm_ASY/meshes/shoulder_link.STL" />
      </geometry>
      <material name="">
        <color rgba="0.792156862745098 0.819607843137255 0.933333333333333 1" />
      </material>
    </visual>
    <collision>
      <origin xyz="0 0 0" rpy="0 0 0" />
      <geometry>
        <mesh filename="package://5-DOF_Arm_ASY/meshes/shoulder_link.STL" />
      </geometry>
    </collision>
  </link>
  <joint name="shoulder_pan" type="revolute">
    <origin xyz="0 0.08968 0" rpy="0 0 0" />
    <parent link="base_link" />
    <child link="shoulder_link" />
    <axis xyz="0 1 0" />
    <limit lower="-1.57" upper="1.57" effort="6" velocity="2.094" />
  </joint>
  <link name="upper_arm_link">
    <inertial>
      <origin xyz="-0.00180750567433341 0.173246571191649 4.08974846701979E-05" rpy="0 0 0" />
      <mass value="0.801352411341916" />
      <inertia ixx="0.00144154894015789" ixy="-7.04457401512263E-05" ixz="-5.86484554602239E-08" iyy="0.00071947200534214" iyz="-1.80844924602218E-07" izz="0.000915020760862957" />
    </inertial>
    <visual>
      <origin xyz="0 0 0" rpy="0 0 0" />
      <geometry>
        <mesh filename="package://5-DOF_Arm_ASY/meshes/upper_arm_link.STL" />
      </geometry>
      <material name="">
        <color rgba="0.752941176470588 0.752941176470588 1 1" />
      </material>
    </visual>
    <collision>
      <origin xyz="0 0 0" rpy="0 0 0" />
      <geometry>
        <mesh filename="package://5-DOF_Arm_ASY/meshes/upper_arm_link.STL" />
      </geometry>
    </collision>
  </link>
  <joint name="shoulder_lift" type="revolute">
    <origin xyz="0 0.122 0" rpy="0 0 0" />
    <parent link="shoulder_link" />
    <child link="upper_arm_link" />
    <axis xyz="-1 0 0" />
    <limit lower="-1.57" upper="1.57" effort="8" velocity="1.571" />
  </joint>
  <link name="elbow_link">
    <inertial>
      <origin xyz="-0.0307332033438824 0.248490296716952 5.4153244018764E-06" rpy="0 0 0" />
      <mass value="0.0657083760191284" />
      <inertia ixx="4.2637205610944E-05" ixy="5.53811761587028E-06" ixz="4.52593449380983E-09" iyy="1.73498252252824E-05" iyz="2.86355028105232E-08" izz="3.88115763209182E-05" />
    </inertial>
    <visual>
      <origin xyz="0 0 0" rpy="0 0 0" />
      <geometry>
        <mesh filename="package://5-DOF_Arm_ASY/meshes/elbow_link.STL" />
      </geometry>
      <material name="">
        <color rgba="0.792156862745098 0.819607843137255 0.933333333333333 1" />
      </material>
    </visual>
    <collision>
      <origin xyz="0 0 0" rpy="0 0 0" />
      <geometry>
        <mesh filename="package://5-DOF_Arm_ASY/meshes/elbow_link.STL" />
      </geometry>
    </collision>
  </link>
  <joint name="elbow_flex" type="revolute">
    <origin xyz="0 0 0" rpy="0 0 0" />
    <parent link="upper_arm_link" />
    <child link="elbow_link" />
    <axis xyz="-1 0 0" />
    <limit lower="-1.57" upper="1.57" effort="6" velocity="2.094" />
  </joint>
  <link name="forearm_link">
    <inertial>
      <origin xyz="-0.00265421705144897 0.0729550851834355 0.000159744100449932" rpy="0 0 0" />
      <mass value="0.0855230311922609" />
      <inertia ixx="2.27627857558119E-05" ixy="4.26014094253286E-06" ixz="-3.01720208836961E-08" iyy="2.63846802670283E-05" iyz="-3.93646159492646E-08" izz="2.90161813728108E-05" />
    </inertial>
    <visual>
      <origin xyz="0 0 0" rpy="0 0 0" />
      <geometry>
        <mesh filename="package://5-DOF_Arm_ASY/meshes/forearm_link.STL" />
      </geometry>
      <material name="">
        <color rgba="0.792156862745098 0.819607843137255 0.933333333333333 1" />
      </material>
    </visual>
    <collision>
      <origin xyz="0 0 0" rpy="0 0 0" />
      <geometry>
        <mesh filename="package://5-DOF_Arm_ASY/meshes/forearm_link.STL" />
      </geometry>
    </collision>
  </link>
  <joint name="wrist_flex" type="revolute">
    <origin xyz="-0.0605 0.272 0" rpy="0 0 0" />
    <parent link="elbow_link" />
    <child link="forearm_link" />
    <axis xyz="0 1 0" />
    <limit lower="-1.57" upper="1.57" effort="2" velocity="3.142" />
  </joint>
  <link name="gripper_link">
    <inertial>
      <origin xyz="-0.0146620900215039 -1.47928303506628E-06 2.68998071692594E-06" rpy="0 0 0" />
      <mass value="0.0286256293963192" />
      <inertia ixx="6.83115713456772E-06" ixy="-9.4092509073956E-11" ixz="1.71059182478324E-10" iyy="4.29016303006166E-06" iyz="1.34827576108317E-09" izz="4.28845291998976E-06" />
    </inertial>
    <visual>
      <origin xyz="0 0 0" rpy="0 0 0" />
      <geometry>
        <mesh filename="package://5-DOF_Arm_ASY/meshes/gripper_link.STL" />
      </geometry>
      <material name="">
        <color rgba="0.792156862745098 0.819607843137255 0.933333333333333 1" />
      </material>
    </visual>
    <collision>
      <origin xyz="0 0 0" rpy="0 0 0" />
      <geometry>
        <mesh filename="package://5-DOF_Arm_ASY/meshes/gripper_link.STL" />
      </geometry>
    </collision>
  </link>
  <joint name="wrist_roll" type="revolute">
    <origin xyz="-0.02075 0.148 0" rpy="0 0 0" />
    <parent link="forearm_link" />
    <child link="gripper_link" />
    <axis xyz="-1 0 0" />
    <limit lower="-1.57" upper="1.57" effort="1.5" velocity="4.189" />
  </joint>
  <link name="end_effector">
    <inertial>
      <origin xyz="0.00636514296160179 0.0126956888962649 -0.000241917415701468" rpy="0 0 0" />
      <mass value="0.106641886707924" />
      <inertia ixx="0.000110378060596757" ixy="5.2629198727399E-06" ixz="-1.08472456105286E-07" iyy="9.16444663141654E-05" iyz="-8.26088251149669E-07" izz="5.06125099618507E-05" />
    </inertial>
    <visual>
      <origin xyz="0 0 0" rpy="0 0 0" />
      <geometry>
        <mesh filename="package://5-DOF_Arm_ASY/meshes/end_effector.STL" />
      </geometry>
      <material name="">
        <color rgba="0.752941176470588 0.752941176470588 0.752941176470588 1" />
      </material>
    </visual>
    <collision>
      <origin xyz="0 0 0" rpy="0 0 0" />
      <geometry>
        <mesh filename="package://5-DOF_Arm_ASY/meshes/end_effector.STL" />
      </geometry>
    </collision>
  </link>
  <joint name="gripper" type="fixed">
    <origin xyz="-0.079773 0 0" rpy="0 0 0" />
    <parent link="gripper_link" />
    <child link="end_effector" />
    <axis xyz="0 0 0" />
  </joint>
</robot>
