ericjhoh/5-DOF-Arm/(commit log)

2026-09-07 Final prints, and final assembly edits
    [15-J1-output.SLDPRT, 15-J1-output.STL, 15-camshaft_ASY.SLDASM, 15-camshaft_part.SLDPRT, 15-disk+output+rollers+flanges_ASY.SLDASM, 15-disk+output+rollers_ASY.SLDASM, 15-disk+output_ASY_ethan.SLDASM, 15-gearbox_ASY.SLDASM]
2026-09-18 Full 5-DOF Assembly
    [15-J1-output.SLDPRT, 15-camshaft_ASY.SLDASM, 15-camshaft_part.SLDPRT, 15-disk+output+rollers+flanges_ASY.SLDASM, 15-disk+output+rollers_ASY.SLDASM, 15-disk+output_ASY_ethan.SLDASM, 15-gearbox_ASY.SLDASM, 15-middle_wall.SLDPRT]
2026-09-20 creating URDF
    [15-J1-output.3mf, 15-disk+output_ASY_ethan.SLDASM, 15-gearbox_ASY.SLDASM, 30-attachment1.SLDPRT, 30-attachment_ASY.SLDASM, 30-disk+output+rollers_ASY.SLDASM, 30-disk+output_ASY.SLDASM, 30_attachement2.SLDPRT]
2026-09-23 Updated Documentation
    [15-disk+output+rollers_ASY.SLDASM, 15-disk+output_ASY_ethan.SLDASM, 30-disk+output+rollers_ASY.SLDASM, 30-disk+output_ASY.SLDASM, 5-DOF-Arm.xlsx, 6-DOF-Arm.xlsx, gear_2024.SLDPRT]
2026-09-23 Rename project from 6-DOF-Arm to 5-DOF-Arm
